open-pisciculture/open-source-fish-farming-prototypes/rfm95w-breakout/README.md

# RFM95W Breakout Board

This is a printed circuit board designed for easier breadboard prototyping with an RFM95W module. 
3D models, PCB documentation and manufacturing files are available. The PCB design Altium project is also included. 

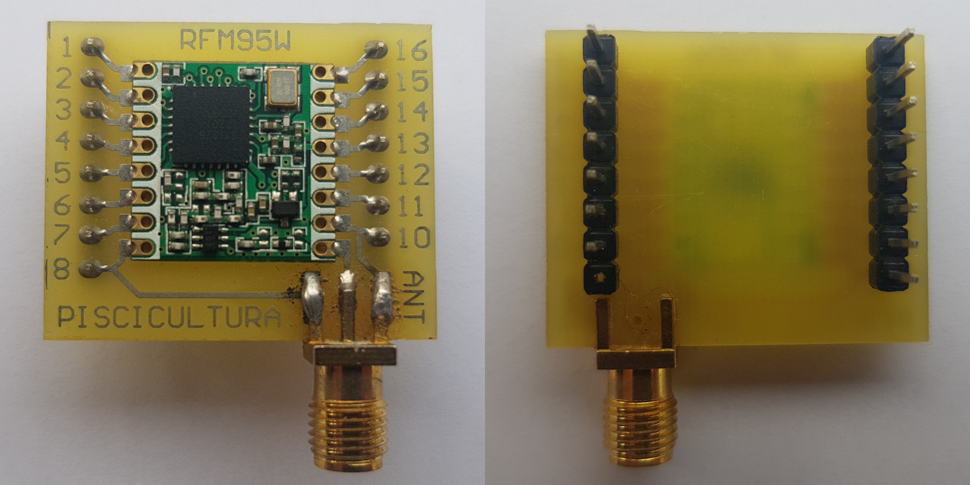
[picture p14: rfm95w-breakout/images/top_and_bottom.jpeg]
RFM95W breakout board front and back views
