open-pisciculture/open-source-fish-farming-prototypes/data-buoy-node/images/view.png

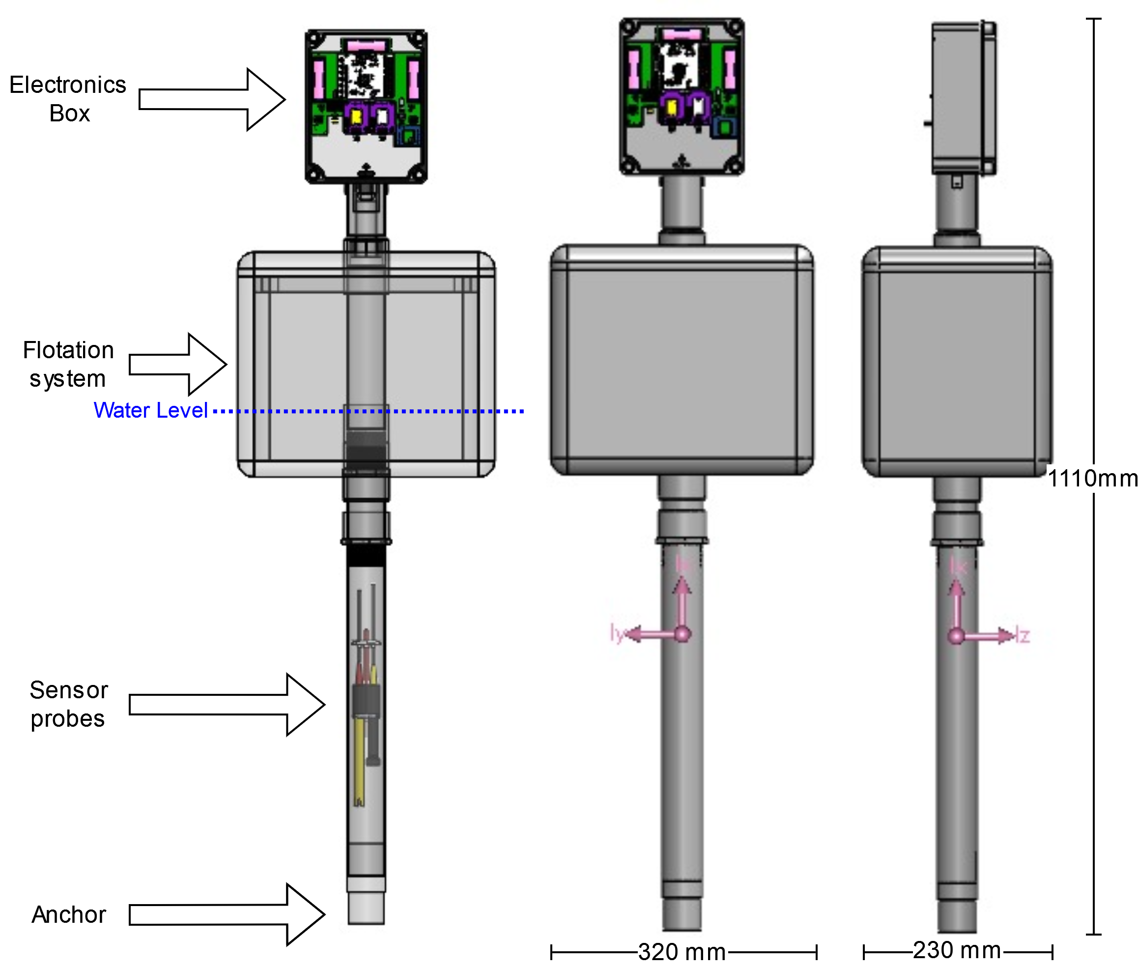
data-buoy-node/images/view.png
