open-pisciculture/open-source-fish-farming-prototypes/data-buoy-node/mechanical/documentation/BoxDimensions.jpeg

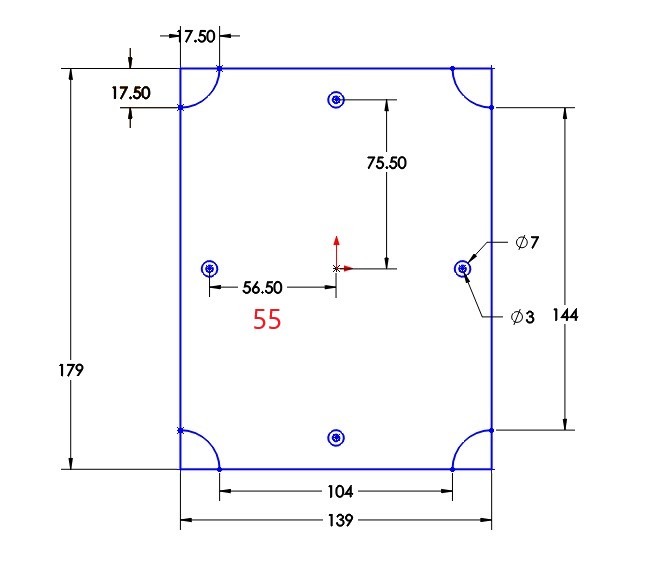
data-buoy-node/mechanical/documentation/BoxDimensions.jpeg
