open-pisciculture/open-source-fish-farming-prototypes/general/images/index.png

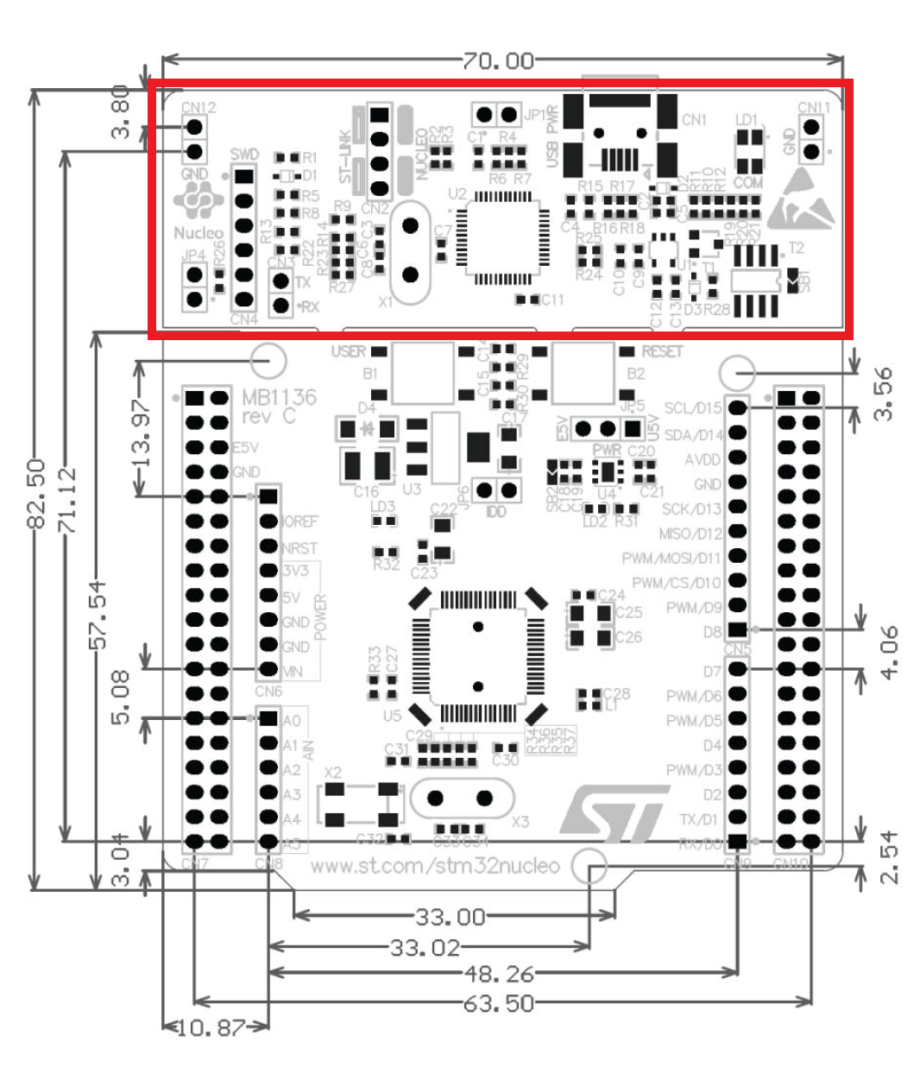
general/images/index.png
