open-pisciculture/open-source-fish-farming-prototypes/general/images/nucleo64_noprogrammer.jpeg

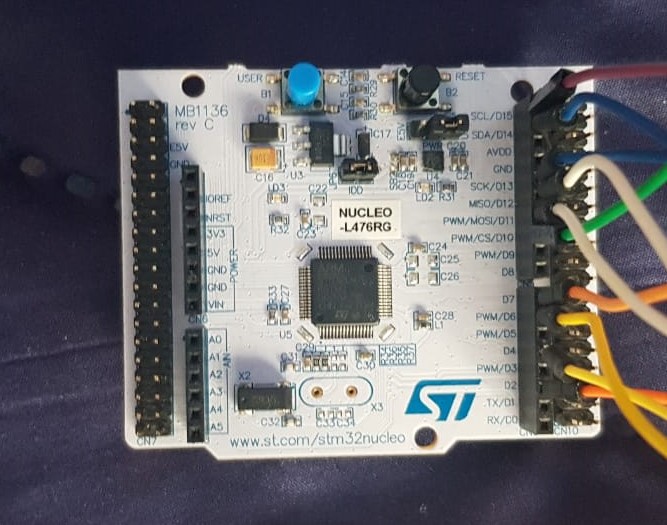
general/images/nucleo64_noprogrammer.jpeg
