open-pisciculture/open-source-fish-farming-prototypes/data-buoy-node/bill_of_materials_colombia.xlsx

Sección | Tipo | Producto | Cantidad | Precio por Unidad (COP) | Precio total (COP) | Precio por Unidad (USD) | Precio Total (USD) | Notas
Mecánica | Partes | Nevera 10 L de poliestireno expandido (https://www.homecenter.com.co/homecenter-co/product/377035/nevera-icopor-10-litros/377035/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) | 1 | $14500.00 | $14500.00
 |  | Caja de derivación 180mm x 140mm x 80mm (https://www.homecenter.com.co/homecenter-co/product/165838/caja-de-derivacion-dexson-gris-18148/165838/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) | 1 | $30900.00 | $30900.00
 |  | Tubo PVC 1 1/2" 1m (https://www.homecenter.com.co/homecenter-co/product/04593/tubo-11-2x1m-presion-21-200-psi/04593/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) | 1 | $11350.00 | $11350.00
 |  | Tubo PVC 3/4" 1m (https://www.homecenter.com.co/homecenter-co/product/04724/tubo-3-4x1m-presion-21-200-psi/04724/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) | 1 | $3450.00 | $3450.00
 |  | Unión PVC 1 1/2" (https://www.homecenter.com.co/homecenter-co/product/04604/union-1-1-2-presion/04604/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) | 1 | $2650.00 | $2650.00
 |  | Adaptador Macho 1 1/2" (https://www.homecenter.com.co/homecenter-co/product/04608/adaptador-macho-11-2-presion/04608/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) | 2 | $4100.00 | $8200.00
 |  | Adaptador Hembra 1 1/2" (https://www.homecenter.com.co/homecenter-co/product/37488/adaptador-hembra-11-2-presion/37488/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) | 2 | $4900.00 | $9800.00
 |  | Buje soldado 1 1/2" x 3/4" (https://www.homecenter.com.co/homecenter-co/product/04748/buje-soldado-11-2x3-4-presion/04748/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) | 1 | $3650.00 | $3650.00
 |  | Tapón soldado 1 1/2" (https://www.homecenter.com.co/homecenter-co/product/04619/tapon-soldado-11-2-presion/04619/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) | 1 | $3800.00 | $3800.00
 |  | Prensa estopa 1/2" 13.5mm (https://www.homecenter.com.co/homecenter-co/product/242697/prensa-estopa-1-2-pulgada-135mm/242697/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) | 1 | $2700.00 | $2700.00
 |  | Unión PVC 3/4 (https://www.homecenter.com.co/homecenter-co/product/04719/union-3-4-presion/04719/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) | 1 | $650.00 | $650.00
Electrónica | Componentes LoRaWAN | Módulo LoRa Transceptor RFM95W 915MHz (https://www.didacticaselectronicas.com/index.php/comunicaciones/lora/m%C3%B3dulo-rf-tranceptor-rfm95w-915mhz-tarjetas-modulos-tranceptores-lora-lo-ra-de-largo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) | 1 | $30464.00 | $30464.00
 |  | RFM95W tarjeta breakout | 1 | $7542.00 | $7542.00 | $2.00 | $2.00 | Costo calculado ordenando una cotización en la página jlcpcb.com y convirtiendo el valor a pesos colombianos
 |  | Cable RF SMA Macho a SMA Hembra 20cm (https://www.didacticaselectronicas.com/index.php/comunicaciones/conectores/extensi%C3%B3n-de-sma-macho-a-sma-hembra-de-20cm-cables-extensiones-extensores-para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) | 1 | $8211.00 | $8211.00
 |  | Terminal Tipo Anillo 6.2mm (https://www.didacticaselectronicas.com/index.php/suiches-y-conectores/conectores2016-02-07-20-36-39_/terminales/terminal-aislada-amarilla-tipo-fast-on-hembra-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) | 1 | $833.00 | $833.00
 |  | Antena 900 MHz 5dBi SMA Macho (https://www.didacticaselectronicas.com/index.php/comunicaciones/antenas/900mhz/antena-900mhz-5dbi-antenas-para-xbee-antenas-para-lora-lo-ra-antenas-omnidirecc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) | 1 | $8806.00 | $8806.00
 | Microcontrolador, Alimentación y demás | NUCLEO-L476RG (https://www.sigmaelectronica.net/producto/nucleo-l476rg/) | 1 | $140420.00 | $140420.00
 |  | Resistencia 5.1kOhms (https://www.sigmaelectronica.net/producto/rax1-4w-1k-ohm-5/) | 2 | $36.00 | $72.00 |  |  | Sigma Electrónica vende mínimo 10 unidades.
 |  | Resistencia 20kOhms (https://www.electronicaplugandplay.com/componentes-pasivos/resistencias/resistencias-de-carbon/product/101-resistencia-20k-1-4-watt) | 1 | $70.00 | $70.00 |  |  | Electrónica Plug and Play vende mínimo 10 unidades.
 |  | MOSFET IRLZ44N (https://www.sigmaelectronica.net/producto/irlz44n/) | 1 | $5950.00 | $5950.00
 |  | Regleta Header Macho 1x40 Pines 2.54mm (https://www.didacticaselectronicas.com/index.php/suiches-y-conectores/headers/header-macho-1x40p-2-54mm-header-macho1x40-regletas-conectores-header-machos-de-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) | 1 | $404.60 | $404.60 |  |  | Separar en las siguientes porciones: 1x2 pines, 2x5 pines, 1x7 pines y 1x8 pines.
 |  | Regleta Header Hembra 2x40 Pines 2.54mm (https://www.didacticaselectronicas.com/index.php/suiches-y-conectores/headers/header-hembra-2x40p-2-54mm-h-hembra-2x40-regletas-conectores-header-hembras-de-2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) | 2 | $1547.00 | $3094.00 |  |  | Quitar 2 pines de un borde de cada regleta para que quede de 2x39 pines.
 |  | Regleta Header Hembra 1x40 Pines 2.54mm (https://www.didacticaselectronicas.com/index.php/suiches-y-conectores/headers/header-hembra-1x40p-2-54mm-con-087-header-hembra-1x40-regletas-conectores-header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) | 1 | $952.00 | $952.00 |  |  | Separar en las siguientes porciones: 2x3 pines, 2x5 pines, 1x7 pines y 1x8 pines.
 |  | Jumper de conexión 2.54mm (https://www.didacticaselectronicas.com/index.php/prototipado/accesorios-1/jumper-de-conexi%C3%B3n-2-54mm-negro-conectores-jumper-jumpers-de-conexion-detail) | 1 | $99.96 | $99.96
 |  | Regulador de voltaje MCP1700 3.3V 250mA (https://www.didacticaselectronicas.com/index.php/semiconductores/reguladores/reguladores-33v/regulador-de-voltaje-3-3v-250ma-mcp1700-3302e-to-reguladores-de-v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) | 1 | $1547.00 | $1547.00
 |  | Capacitor 1uF (https://www.didacticaselectronicas.com/index.php/componentes-pasivos/capacitores/de-tantalio/capacitor-de-tantalio-1uf-35v-condensadores-capacitores-condensad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) | 2 | $499.80 | $999.60
 |  | Switch mini deslizante 3 pines (https://www.didacticaselectronicas.com/index.php/suiches-y-conectores/suiches/deslizante/suiche-mini-deslizante-3-pines-2-posiciones-suiches-switch-interrupto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) | 1 | $345.10 | $345.10
 |  | Bornera 2 Pines (https://www.didacticaselectronicas.com/index.php/suiches-y-conectores/borneras/bornera-2p-azul-kf301-5mm-kf301-2p-tb2pos5b-borneras-terminales-con-borneras-sc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) | 2 | $476.00 | $952.00
 |  | Porta pila AA x1 (https://www.didacticaselectronicas.com/index.php/baterias-cargadores/portabaterias/porta-pila-aa-x1-portapilas-portabaterias-holder-soportes-para-bater%C3%ADa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) | 3 | $714.00 | $2142.00
 |  | Pila AA 2 unidades (https://www.exito.com/pilas-duracell-aa-2pz-12itx4ip-193555/p) | 2 | $9000.00 | $18000.00 |  |  | Se vende por 2 unidades. Solo se requieren 3 en el prototipo. Se puede cambiar por otra pila AA que también tenga tensión nominal de 1.5V.
 |  | Tornillo M3 x 6mm (https://www.didacticaselectronicas.com/index.php/robotica/tornillos-y-separadores/tornillos/tornillo-plastico-6mm-unidad-tornillos-metalicos-m3-6mm-detail) | 5 | $202.30 | $1011.50
 |  | Circuito Impreso Electrónica | 1 | $43743.60 | $43743.60 | $11.60 | $11.60 | Costo calculado ordenando una cotización en la página jlcpcb.com y convirtiendo el valor a pesos colombianos
Sensórica | Sondas, circuitos de lectura y conectores | Conector SMA Hembra (https://www.vistronica.com/conectores-cables-y-switches/conector-sma-ke-11mm-detail.html) | 1 | $1558.52 | $1558.52
 |  | Adaptador SMA Macho a BNC Hembra (https://www.amazon.com/-/es/Electronics-coaxial-adaptador-macho-hembra/dp/B00CVQLDX4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) | 1 | $18855.00 | $18855.00 | $5.00 | $5.00 | Se incluye link de Amazon como referencia, ya que no se encontraron distribuidores nacionales que vendan este producto por página web.
 |  | PT-1000 Temperature Kit (https://atlas-scientific.com/kits/pt-1000-temperature-kit/) | 1 | $279016.29 | $279016.29 | $73.99 | $73.99
 |  | pH Kit (https://atlas-scientific.com/kits/ph-kit/) | 1 | $644803.29 | $644803.29 | $170.99 | $170.99
 |  | Dissolved Oxygen Kit | 1 | $1172743.29 | $1172743.29 | $310.99 | $310.99
 |  | Sección | Precio Total (COP) | Porcentaje del Precio Total (%) |  | USD-COP | 3771
 |  | Mecánica | $91650.00 | 3.69%
 |  | Electrónica | $275659.36 | 11.10%
 |  | Sensórica | $2116976.39 | 85.21%
 |  | Prototipo Completo | $2484285.75 | 100.00%
 |  | Precio Total del Prototipo (USD) | $658.79
 |  | Section | Total Price (USD) | Percentage of Total Price (%)
 |  | Mechanical Structure | $24.30 | 3.69%
 |  | Electronics | $73.10 | 11.10%
 |  | Sensors | $561.38 | 85.21%
 |  | Complete Prototype | $658.79 | 100.00%
