open-pisciculture/open-source-fish-farming-prototypes/data-buoy-node/bill_of_materials.xlsx

BILL OF MATERIALS - DATA BUOY NODE
Description | Quantity needed
Circuit Components
HopeRF RFM95W module (https://www.hoperf.com/modules/lora/RFM95.html) | 1
RF cable SMA Male to SMA Female 15cm (https://www.amazon.com/-/es/TUOLNK-unidades-coaxial-adaptador-inal%C3%A1mbrica/dp/B091TH6CCJ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) | 1
NUCLEO-L476RG (https://www.st.com/en/evaluation-tools/nucleo-l476rg.html) | 1
5.1kOhms Resistor | 2
20KOhms Resistor | 1
IRLZ44N MOSFET (https://www.infineon.com/cms/en/product/power/mosfet/n-channel/irlz44n/) | 1
SMA Male to BNC Female Adapter | 1
PT-1000 Temperature Kit (https://atlas-scientific.com/kits/pt-1000-temperature-kit/) | 1
pH Kit (https://atlas-scientific.com/kits/ph-kit/) | 1
Dissolved Oxygen Kit (https://atlas-scientific.com/kits/dissolved-oxygen-kit/) | 1
Male Header Pin | 12
Female Header Pin | 92
Mini Slide Switch 3 Pin (https://www.pololu.com/product/1408) | 1
MCP1700 (https://www.microchip.com/en-us/product/MCP1700) | 1
1uF capacitor | 2
2 Pin Screw Terminal Block Connector | 2
AAx1 Battery Holder | 3
AA Battery | 3
Mechanical Parts
10L Polystyrene box | 1
PVC Pipe 1 1/2" | 1m
PVC Pipe 3/4" | 1m
PVC Coupling 1 1/2" | 1
PVC Male adapter 1 1/2" | 2
PVC Female adapter 1 1/2" | 2
PVC Reducer Bushing 1 1/2" x 3/4" | 1
PVC cap 1 1/2" | 1
Cable Gland PG13.5 | 1
PVC Coupling 3/4" | 1
