open-pisciculture/open-source-fish-farming-prototypes/gps-node/bill_of_materials.xlsx

BILL OF MATERIALS - GPS NODE
Description | Quantity needed
Circuit Components
GY-NEO6MV2 GPS Module | 1
HopeRF RFM95W module (https://www.hoperf.com/modules/lora/RFM95.html) | 1
NUCLEO-L476RG (https://www.st.com/en/evaluation-tools/nucleo-l476rg.html) | 1
Male Header Pin | 4
MCP1700 (https://www.microchip.com/en-us/product/MCP1700) | 1
2 Pin Screw Terminal Block Connector | 1
1uF capacitor | 2
AAx3 Battery Holder | 1
AA Battery | 3
Breadboard | 1
Cables and Jumpers | -
PLA filament | -
