open-pisciculture/open-source-fish-farming-prototypes/data-buoy-node/mechanical/3dmodels/step/DataBuoy.step

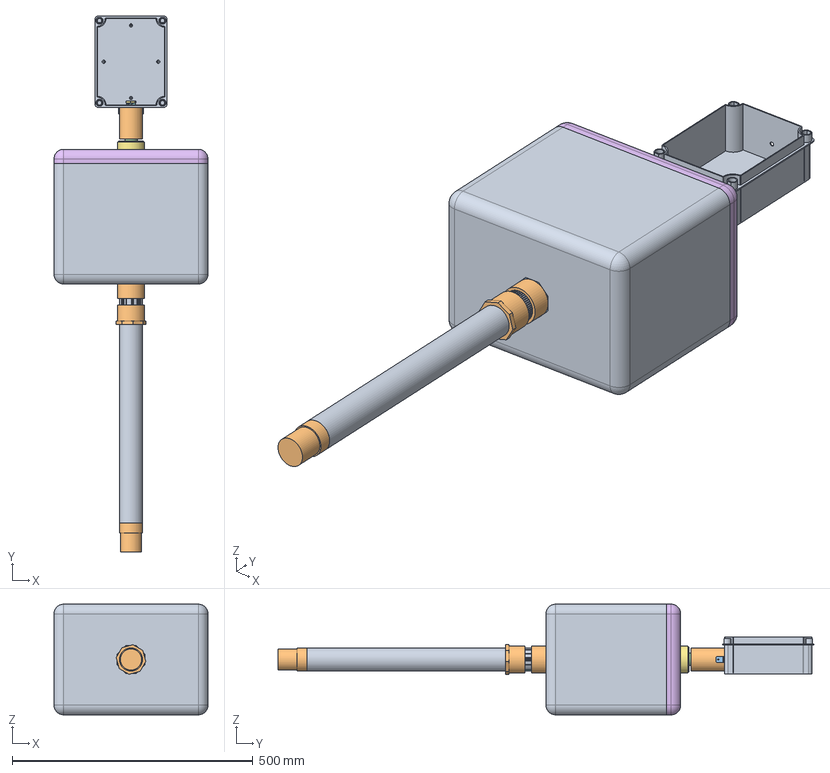
[picture p20: CAD file, 2022-04-05]
data-buoy-node/mechanical/3dmodels/step/DataBuoy.step
320.0 x 1114.0 x 230.0 mm
Nevera 10l
Macho 1_1_2 x 2
Sellador_elastico
Hembra 1-1-2 x 2
PVC 1-1-2-300mm
Tapa_nevera
Transicion_PVC_1_1_2
PVC 1-1-2-100mm
PVC 1-1-2-500mm
Tapon_peso
Buje_1_1_2_a_3_4
Prensa
estopa
Caja de paso Dexson
PVC 1-1-2-70mm
escuadra x 2
