open-pisciculture/open-source-fish-farming-prototypes/gps-node/mechanical/3dprinting/stl/gps-node-box.stl

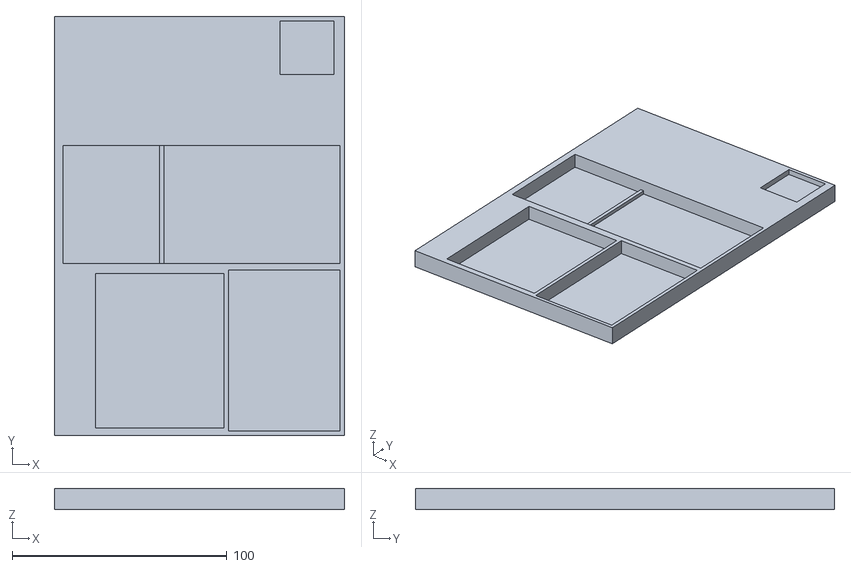
[picture p21: CAD file, 2022-03-02]
gps-node/mechanical/3dprinting/stl/gps-node-box.stl
135.0 x 195.0 x 10.0
