open-pisciculture/open-source-fish-farming-prototypes/rfm95w-breakout/3dmodels/RFM95W.step

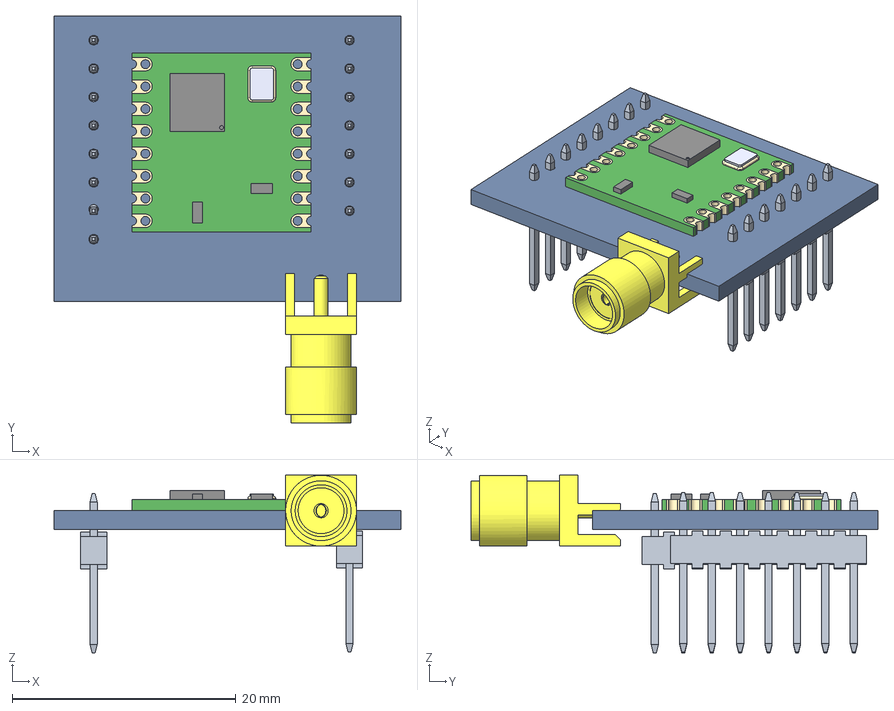
[picture p22: CAD file, 2022-03-01]
rfm95w-breakout/3dmodels/RFM95W.step
31.0 x 36.3 x 15.9 mm
SMA-J-P-H-ST-EM1
