open-pisciculture/open-source-fish-farming-prototypes/rfm95w-breakout/altium/3DModels/SMA-J-P-H-ST-EM1.stp

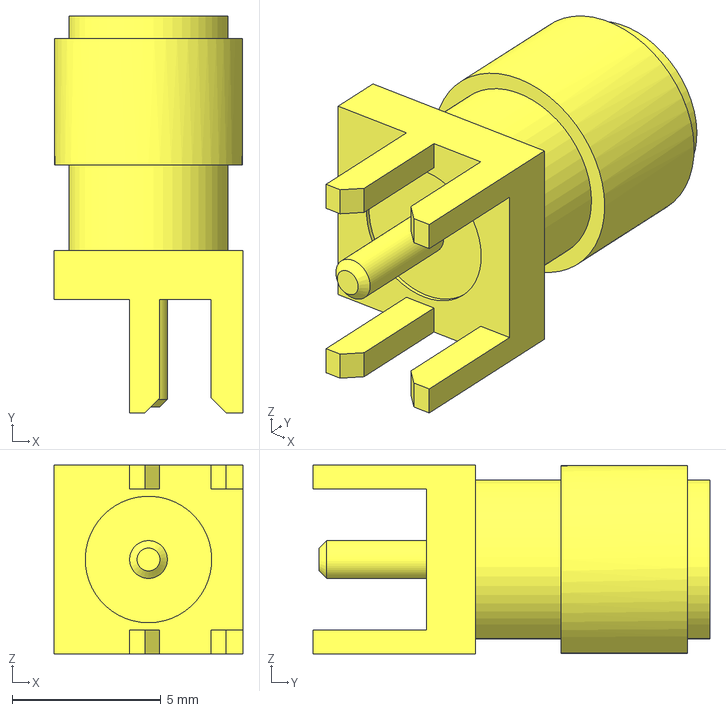
[picture p23: CAD file, 2022-03-01]
rfm95w-breakout/altium/3DModels/SMA-J-P-H-ST-EM1.stp
6.35 x 13.3 x 6.35 mm
