open-pisciculture/open-source-fish-farming-prototypes/rfm95w-breakout/altium/3DModels/022102071.stp

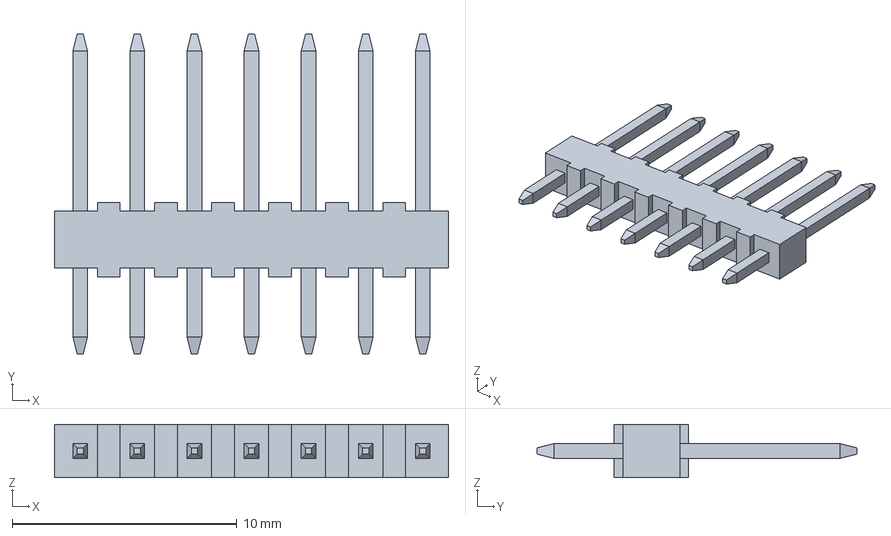
[picture p24: CAD file, 2022-03-01]
rfm95w-breakout/altium/3DModels/022102071.stp
17.5 x 14.2 x 2.36 mm
