open-pisciculture/open-source-fish-farming-prototypes/rfm95w-breakout/altium/3DModels/022102061.stp

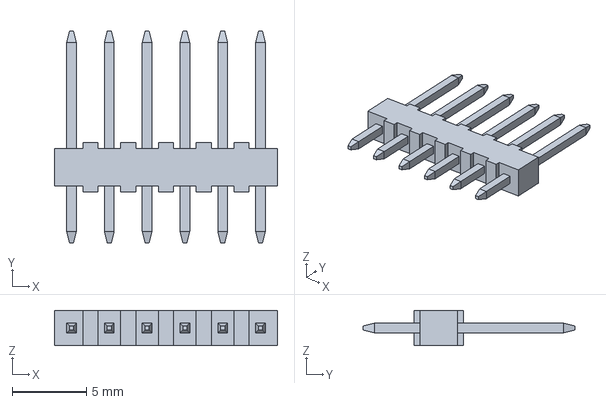
[picture p25: CAD file, 2022-03-01]
rfm95w-breakout/altium/3DModels/022102061.stp
15.0 x 14.2 x 2.36 mm
