open-pisciculture/open-source-fish-farming-prototypes/rfm95w-breakout/altium/3DModels/022102081.stp

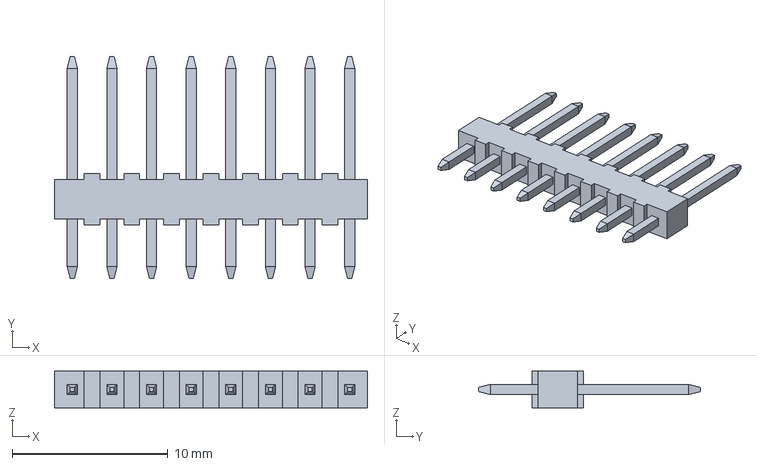
[picture p26: CAD file, 2022-03-01]
rfm95w-breakout/altium/3DModels/022102081.stp
20.1 x 14.2 x 2.36 mm
