open-pisciculture/open-source-fish-farming-prototypes/(list of files, cad)

Other CAD files:
gps-node/mechanical/3dprinting/step/gps_node_box_v1 v3.step
