open-pisciculture/open-source-fish-farming-prototypes/data-buoy-node/assembly_guide.docx

Assembly guide

1. Parts list
2. Subsection assembly
3. Final assembly
1. Parts list

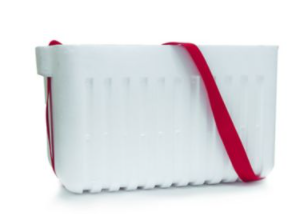
[picture p27: figure]

a) 10 L polystyrene box (x1)

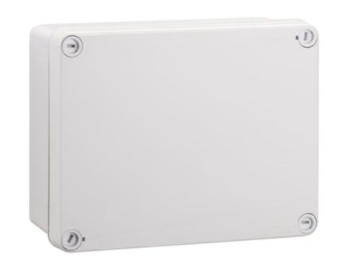
[picture p28: figure]

b) Electrical box 180mm x 140mm x 80mm (x1)

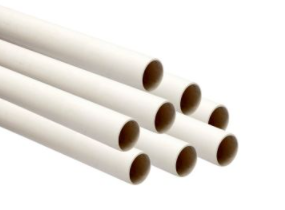
[picture p29: figure]

c) PVC Pipe 1 1/2" cut to 600mm length (x1) d) PVC Pipe 1 1/2" cut to 180mm length (x1)

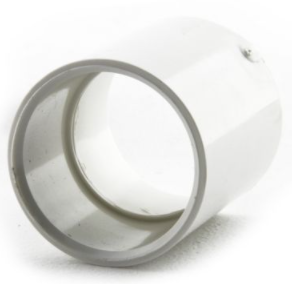
[picture p30: figure]
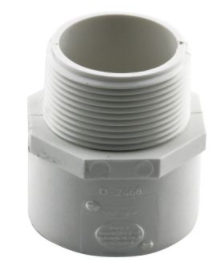
[picture p31: figure]
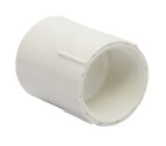
[picture p32: figure]

e) PVC Coupling 1 1/2" (x1) f) Male adapter 1 1/2" (x2) g) Female adapter 1 1/2" (x2)

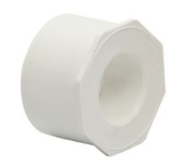
[picture p33: figure]
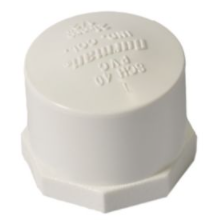
[picture p34: figure]

h) PVC reducer bushing 1 1/2" x 3/4" (x1) i) PVC cap 1 1/2" (x1)

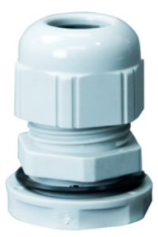
[picture p35: figure]
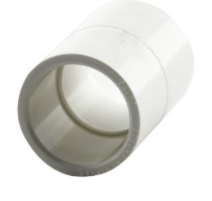
[picture p36: figure]

j) Cable Gland PG13.5 1/2" (x1) k) PVC Coupling 3/4" (x1)

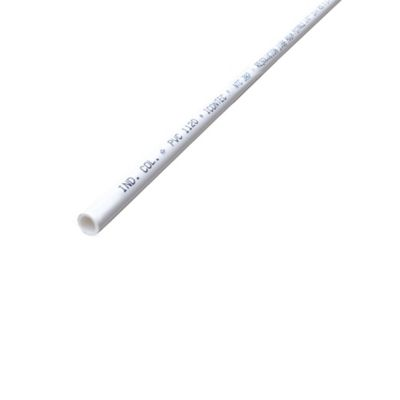
[picture p37: figure]
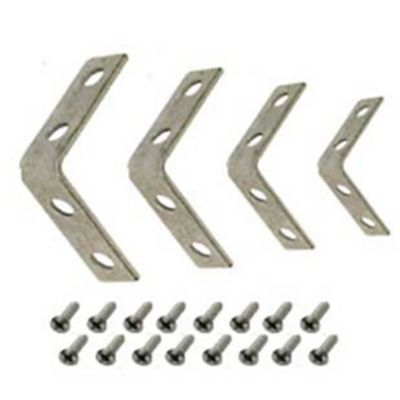
[picture p38: figure]

l) PVC Pipe 3 /4" cut to 50mm length (x1) m) PVC Pipe 3 /4" cut to 70mm length (x1) n) L shape clamp (x2) and screws o) Teflon

2. Subsection assembly

2.1 Buoy

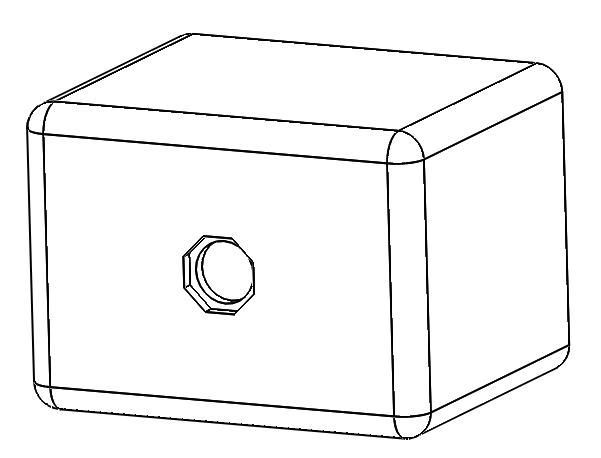
[picture p39: figure]
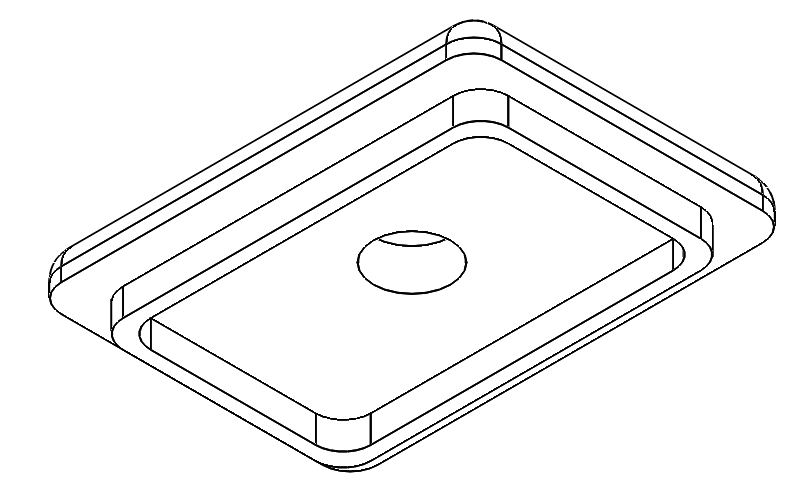
[picture p40: figure]

- Mark the center of the base and cap of the 10L box. - Drill a 47mm diameter hole for the box base. This corresponds to the diameter of accessory (f). - Drill a 56 mm diameter hole for the box cap. This corresponds to the diameter of accessory (e).

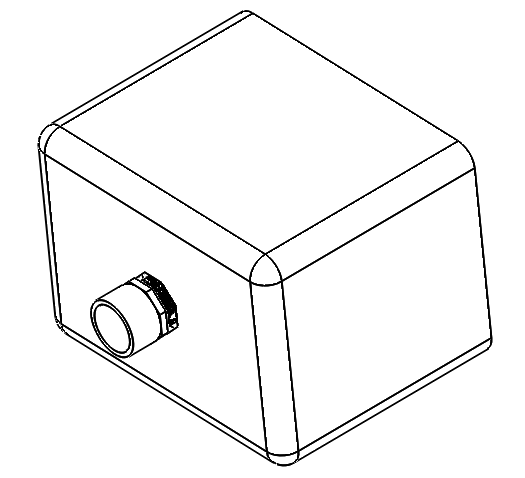
[picture p41: figure]
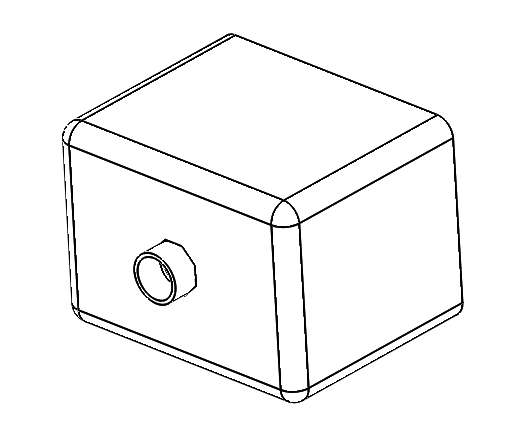
[picture p42: figure]
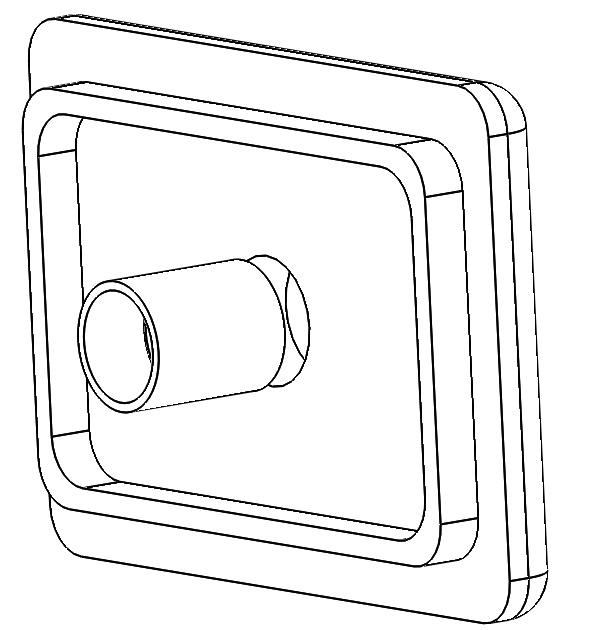
[picture p43: figure]
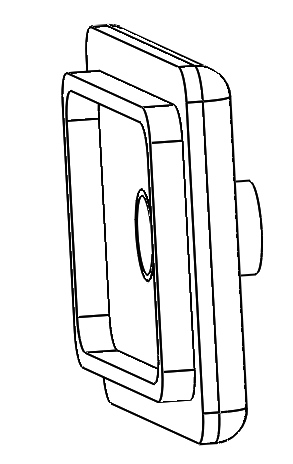
[picture p44: figure]

- Insert the male adapter (f) into the box base and join them with your preferred elastic sealant. - Insert the coupling (e) to the box cap and join them with your preferred elastic sealant.

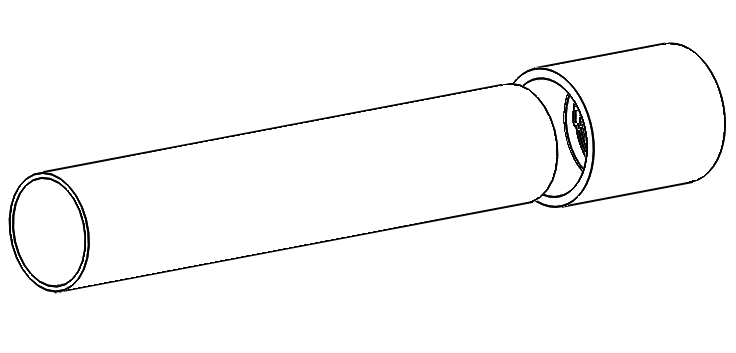
[picture p45: figure]
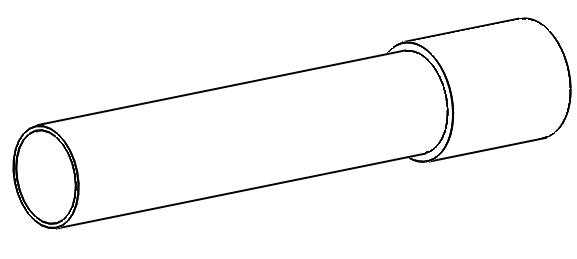
[picture p46: figure]

- Inside the box, weld the female adapter (g) with PVC pipe (d) to join the male adapter (f) and coupling (e).

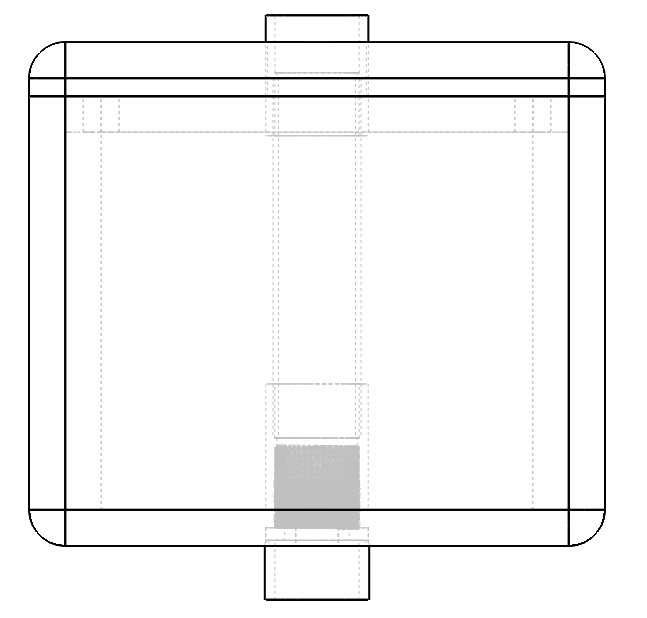
[picture p47: figure]
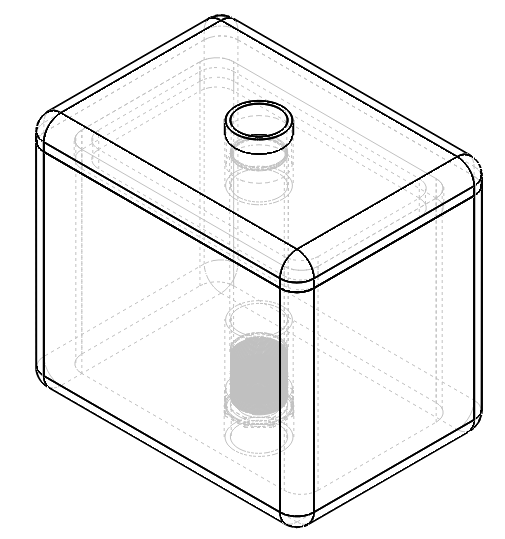
[picture p48: figure]

- Use Teflon on the male adapter (f) thread and adjust the female adapter (g).

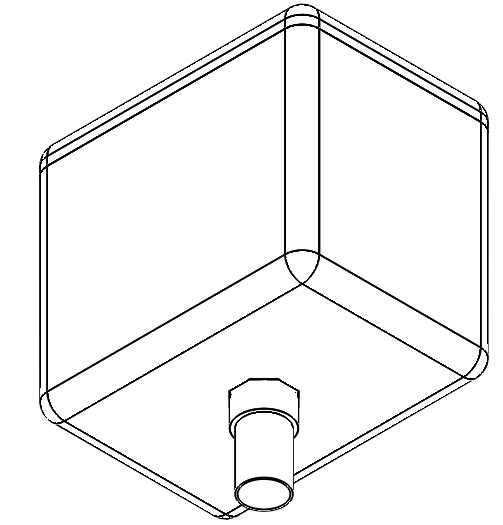
[picture p49: figure]
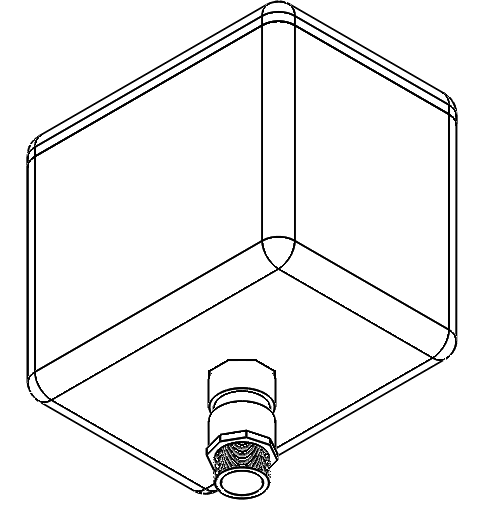
[picture p50: figure]

- Finally, weld the bottom section of the remaining male adapter (f) using a small piece of PVC pipe.

2.2 Electronic devices protection

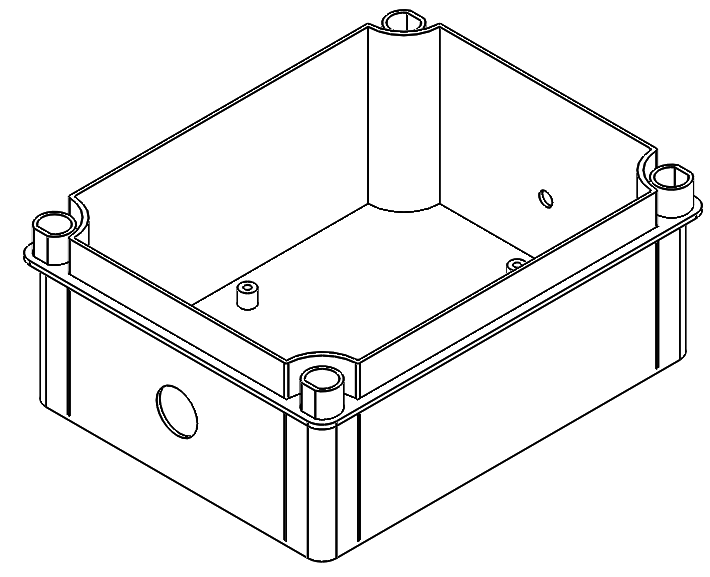
[picture p51: figure]

- Mark the center of the top and bottom sections of the box (b) (140 mm x 80mm side). - For the bottom section, drill a 1/2" diameter hole and clean the borders. The cable gland (j) will be placed here. - For the top section, drill a 1/4" diameter hole where the antenna will be located.

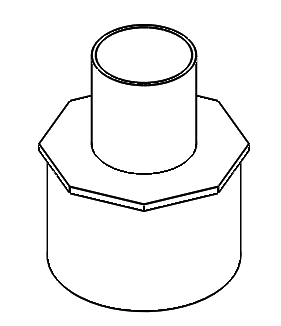
[picture p52: figure]

- Weld the reducer bushing (h) to the 50mm section of 3 /4" PVC pipe (I).

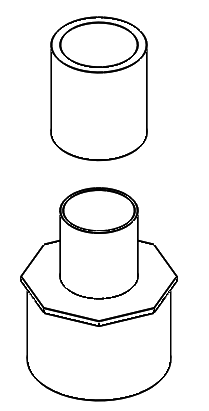
[picture p53: figure]
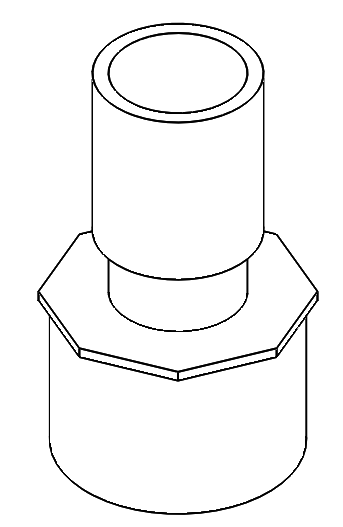
[picture p54: figure]

- Weld the top section of the 3 /4" PVC pipe to the coupling (k).

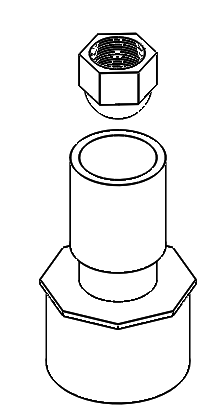
[picture p55: figure]
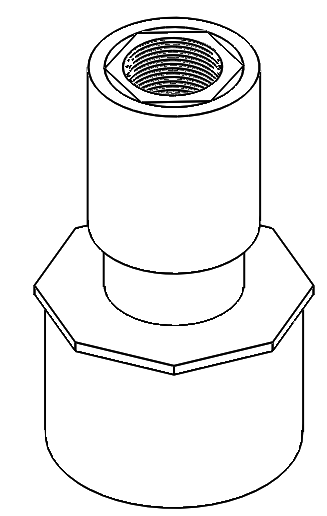
[picture p56: figure]

- Take the thread of element (j) and insert it into the top section of the coupling (k). Use your preferred sealant to join them.

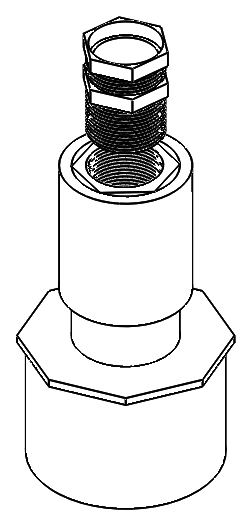
[picture p57: figure]
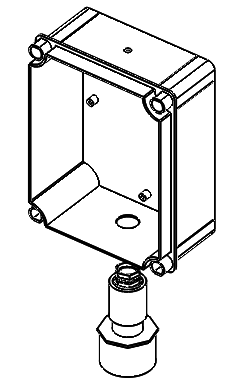
[picture p58: figure]
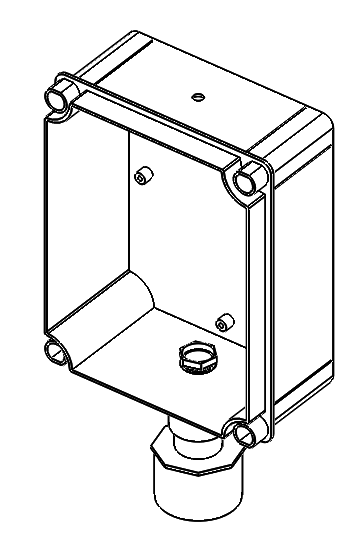
[picture p59: figure]

- Adjust accessory (j) to the box (b) and the thread from the earlier step.

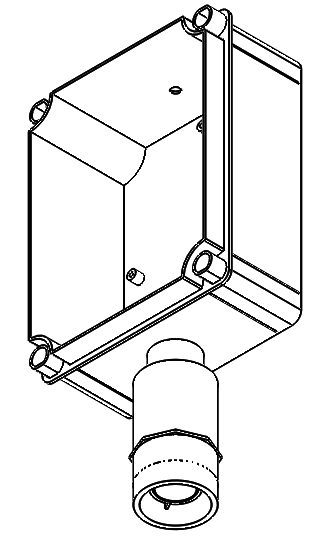
[picture p60: figure]
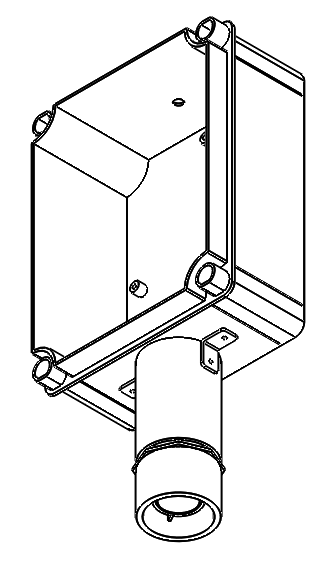
[picture p61: figure]

- Finally, to protect the accessory (j) and increase the box stability, a 70mm section of PVC pipe (m) is added and secured with an L shape clamp and screws (n).

2.3 Sensor probe protection

- Weld the cap (i) to one side of the PVC pipe (c).
- On the other side, place the female accessory (g).

3. Final assembly

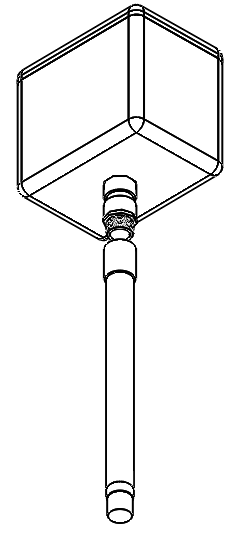
[picture p62: figure]

- Take the buoy and probe protection from sections 2.1 and 2.3 and assemble them by screwing the male and female accessories.

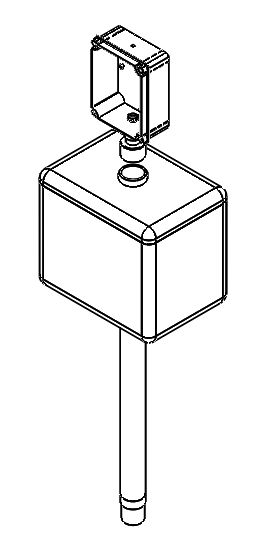
[picture p63: figure]

- Finally, grab the electronics protection from section 2.2 and adjust the accessory (e) to the accessory (h).
