open-pisciculture/open-source-fish-farming-prototypes/data-buoy-node/images/operating.jpeg

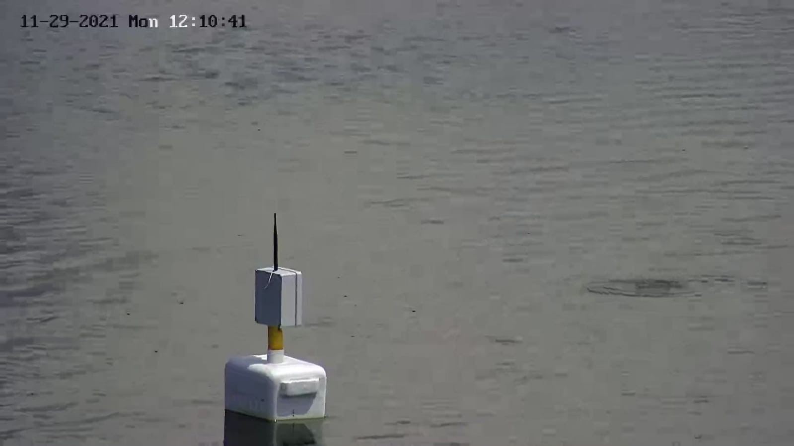
data-buoy-node/images/operating.jpeg
