open-pisciculture/open-source-fish-farming-prototypes/CHANGES.TXT.txt

## CHANGES LOG FILE ##
# INFORMATION CAN ONLY BE ADDED AND NOT REMOVED FROM THIS FILE
# PLEASE NOTE WHEN THE DESIGN HAS CHANGED, INCLUDING DATE AND INFORMATION ABOUT THE CHANGES
# CONSULT THE CERN-OHL-P HOW TO GUIDE FOR DETAILS

# 14/3/2022 # 
ORIGINAL DESIGN UPLOAD
