open-pisciculture/open-source-fish-farming-prototypes/rfm95w-breakout/documentation/RFM95W_Breakout_Schematics.pdf

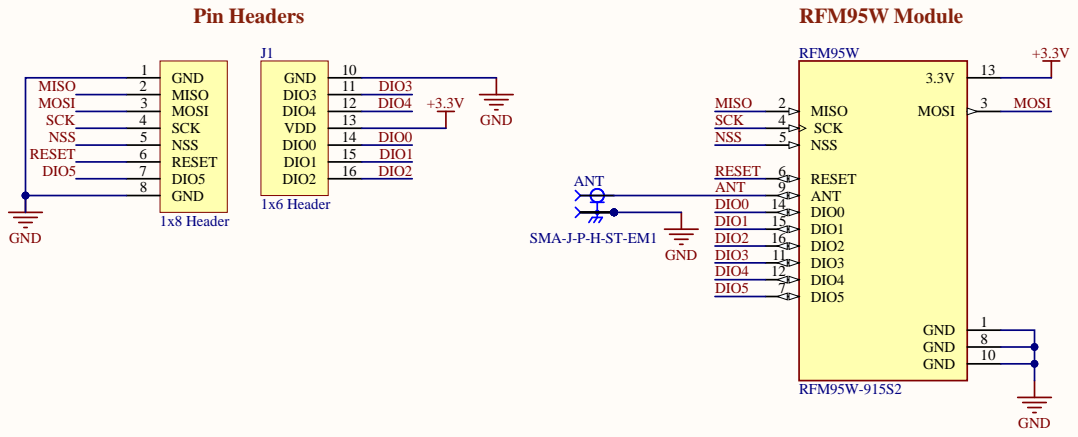
[picture p65: page 1]

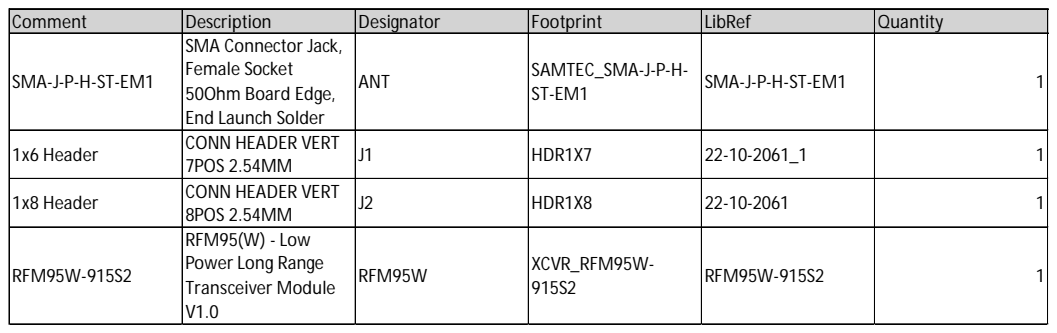
[picture p66: page 2]

Comment | Description | Designator | Footprint | LibRef | Quantity
SMA-J-P-H-ST-EM1 | SMA Connector Jack, Female Socket 50Ohm Board Edge, End Launch Solder | ANT | SAMTEC_SMA-J-P-H-ST-EM1 | SMA-J-P-H-ST-EM1 | 1

1x6 Header | CONN HEADER VERT 7POS 2.54MM | J1 | HDR1X7 | 22-10-2061_1 | 1

1x8 Header | CONN HEADER VERT 8POS 2.54MM | J2 | HDR1X8 | 22-10-2061 | 1

RFM95W-915S2 | RFM95(W) - Low Power Long Range Transceiver Module V1.0 | RFM95W | XCVR_RFM95W-915S2 | RFM95W-915S2 | 1
