open-pisciculture/open-source-fish-farming-prototypes/data-buoy-node/hardware/documentation/BuoyLoRaNode_PCB_Layout.pdf

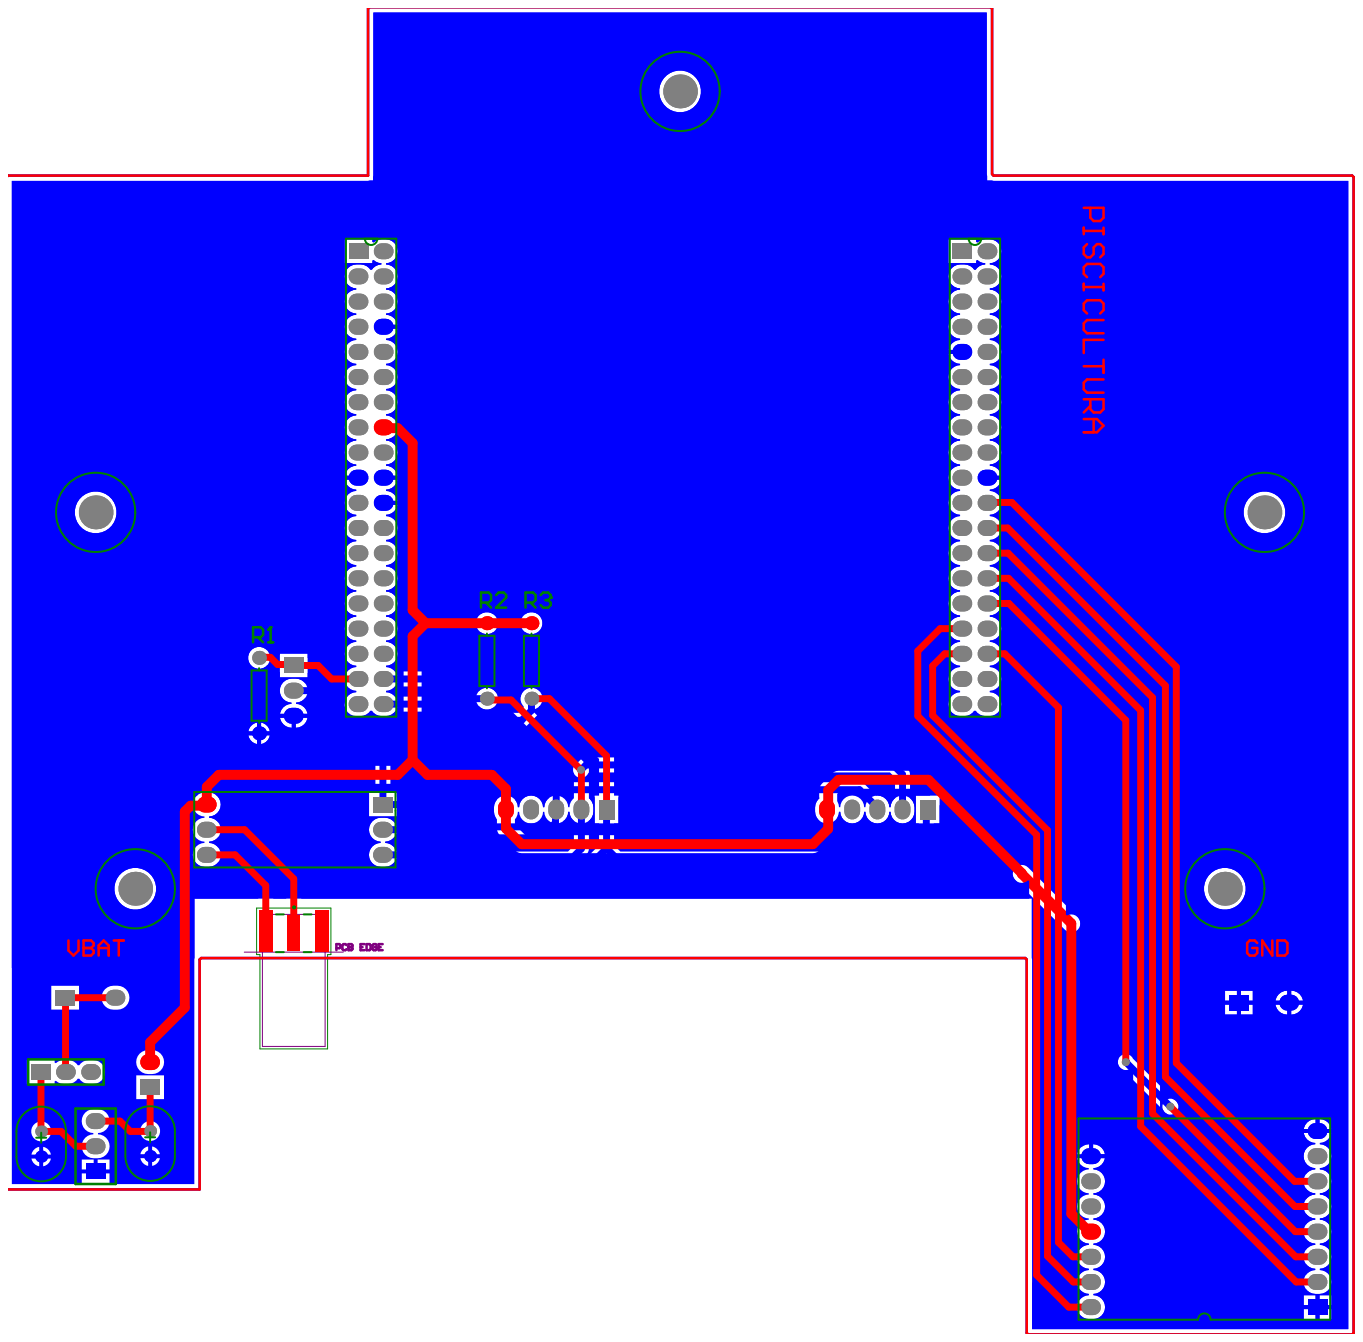
[picture p67: page 1]
