open-pisciculture/open-source-fish-farming-prototypes/data-buoy-node/hardware/altium/BuoyLoRaNode.pdf

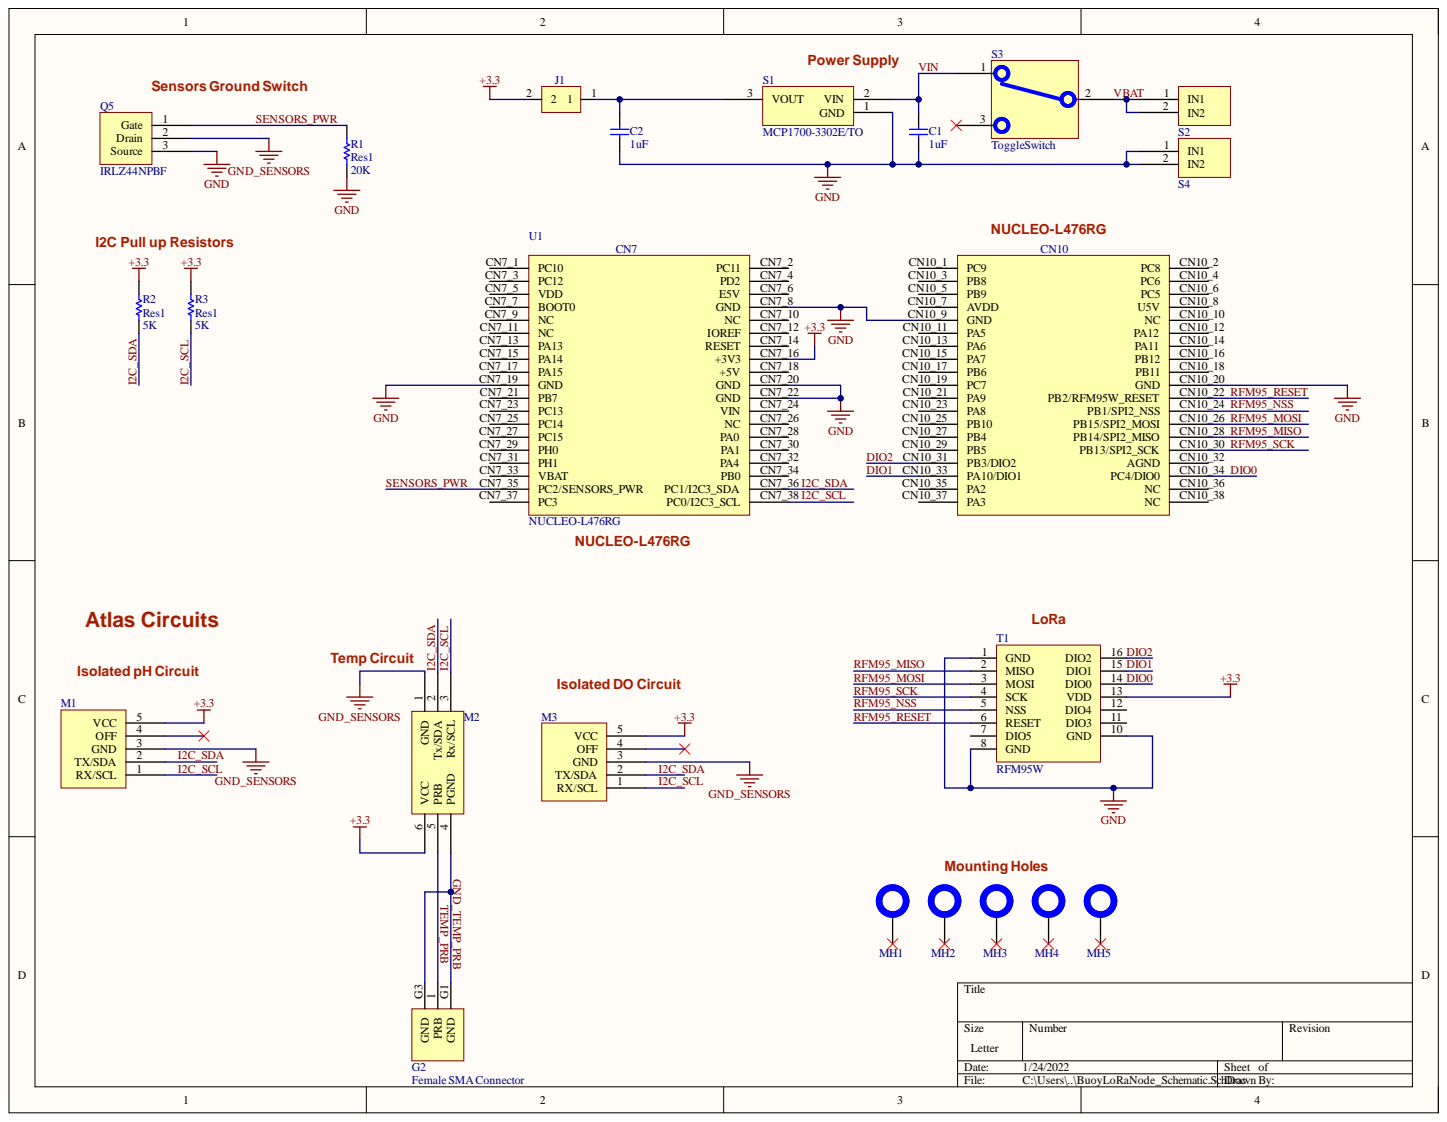
[picture p68: page 1]

Rx/SCL 3 PGND 4 PRB 5 VCC 6

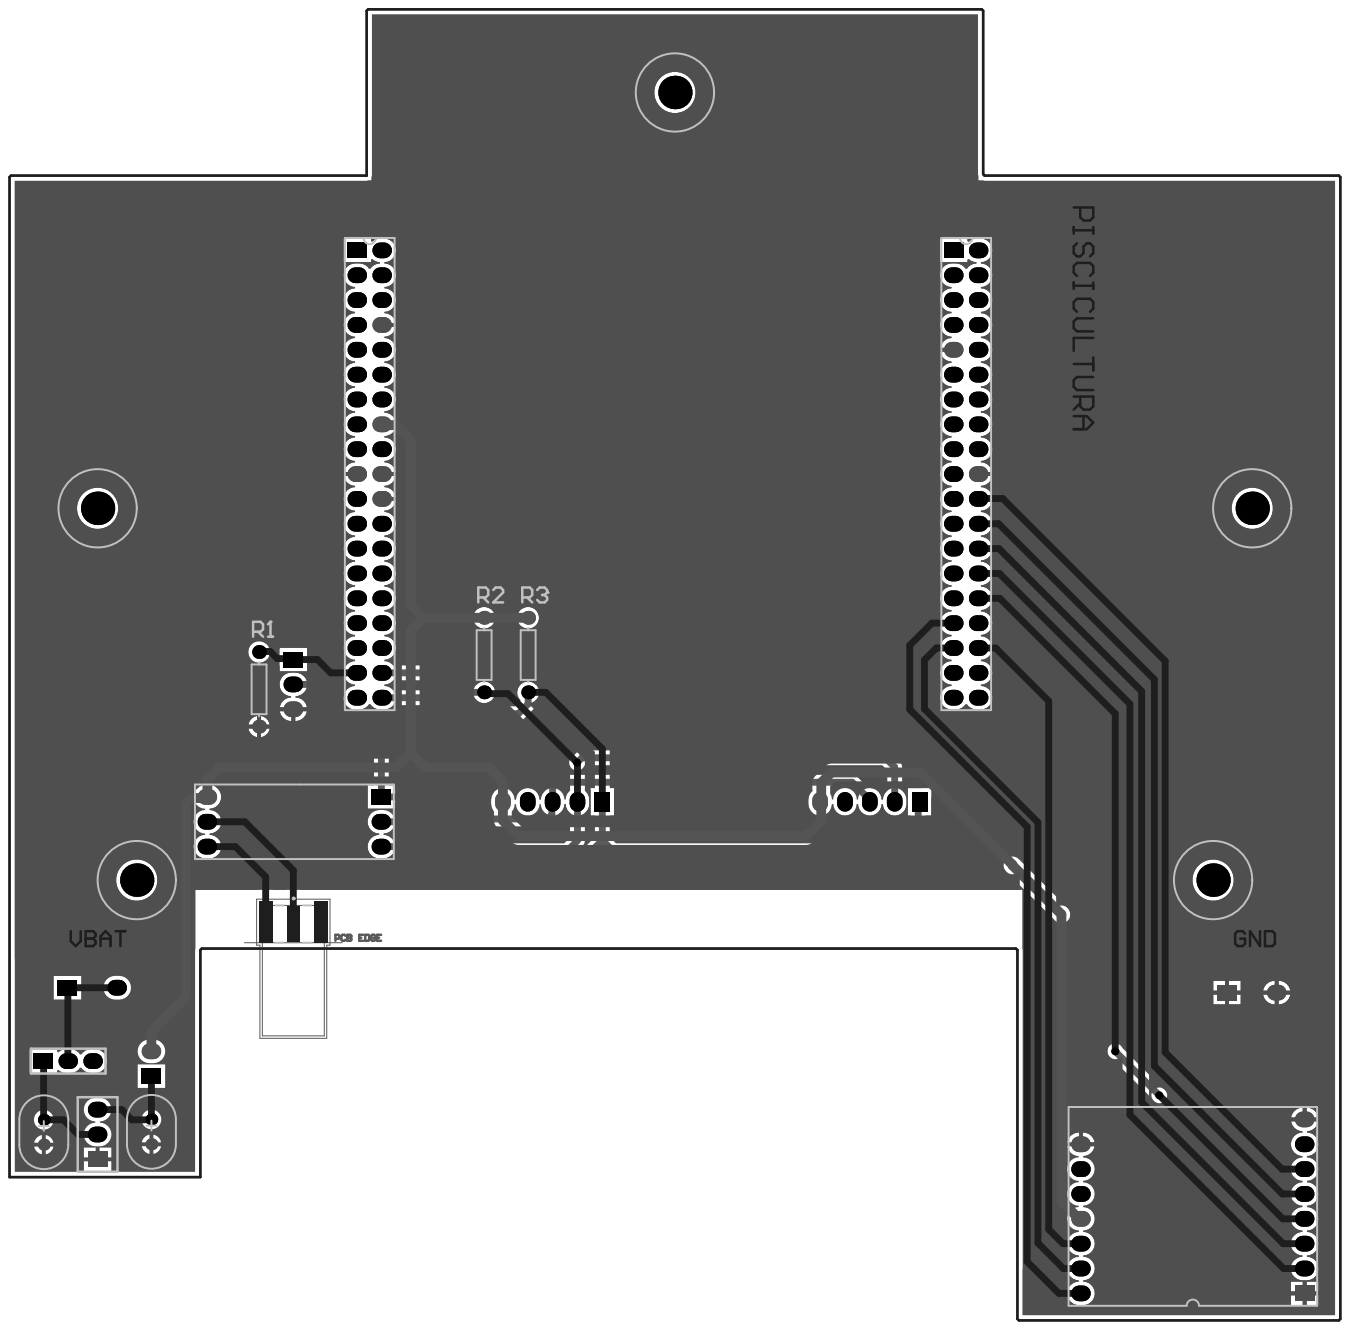
[picture p69: page 2]
