open-pisciculture/open-source-fish-farming-prototypes/gps-node/hardware/altium/GPSLoRaNode_Schematic.pdf

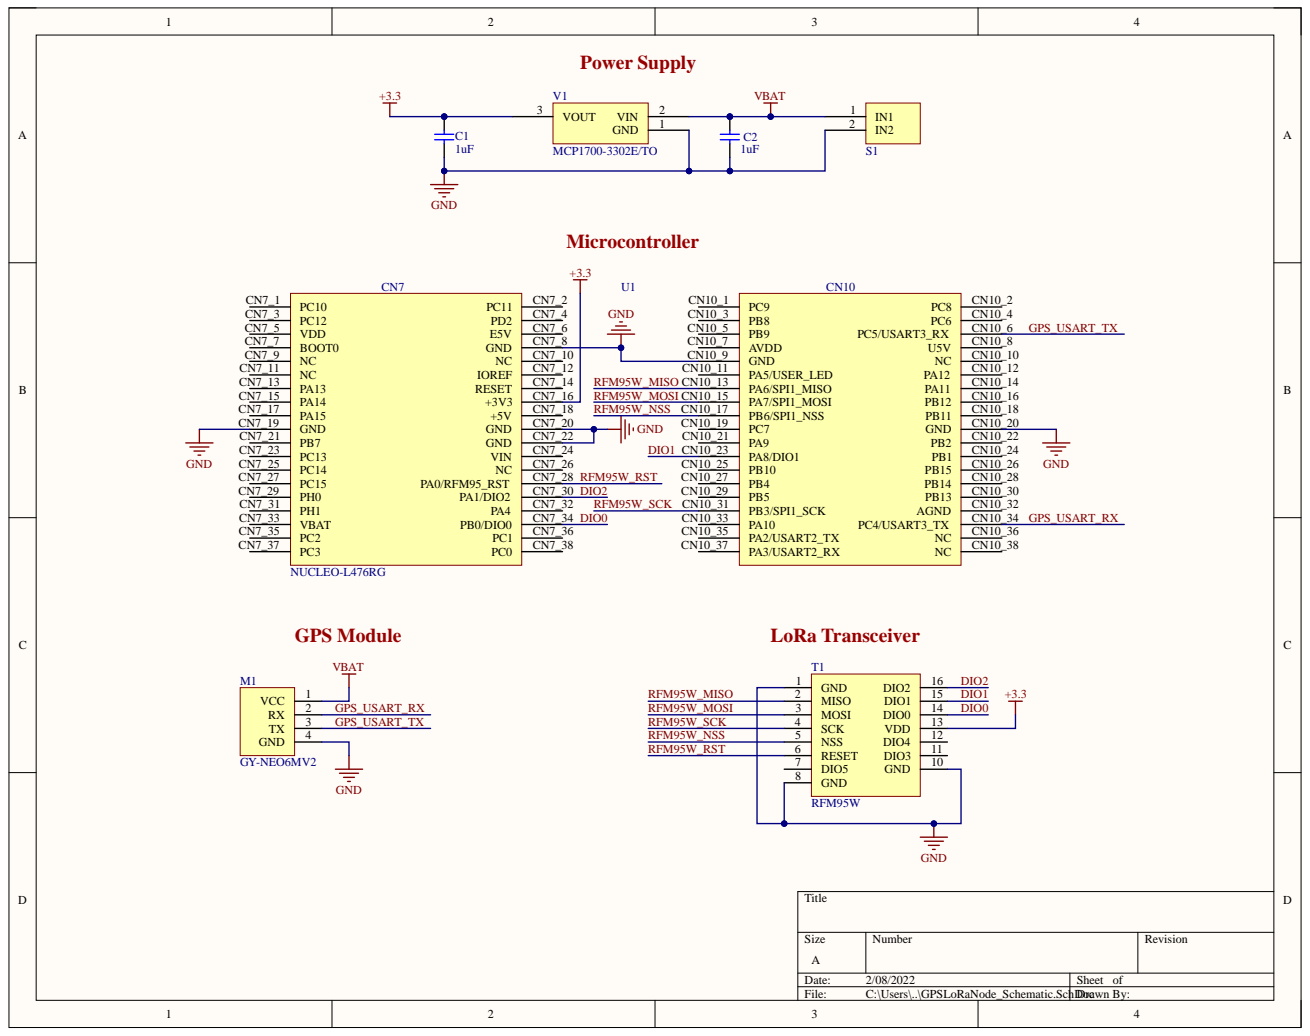
[picture p70: page 1]
