open-pisciculture/open-source-fish-farming-prototypes/gps-node/hardware/documentation/GPSLoRaNode_Schematics.pdf

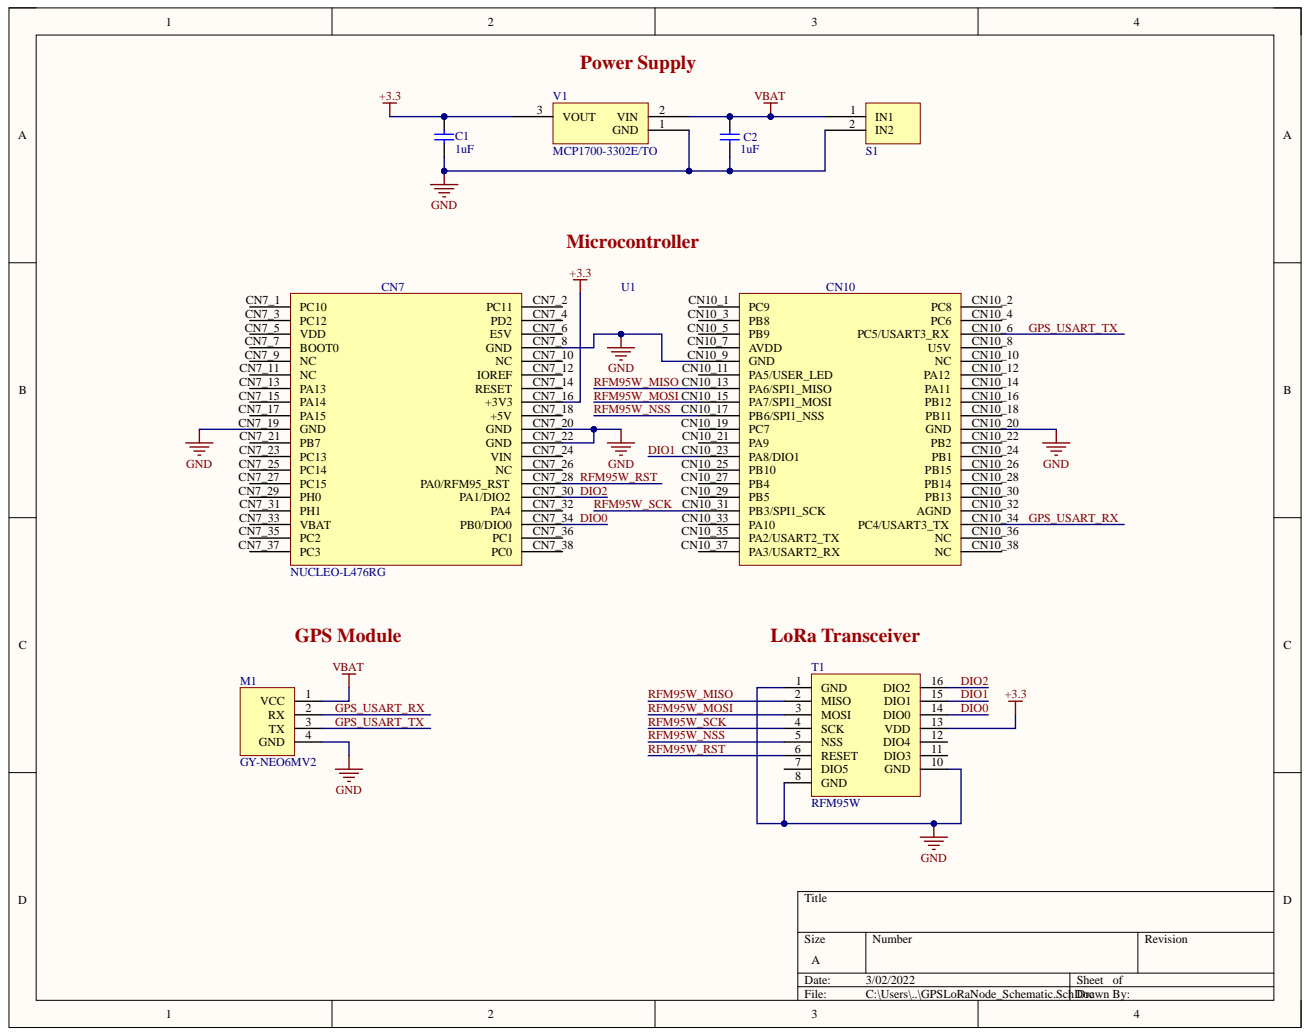
[picture p71: page 1]
