open-pisciculture/open-source-fish-farming-prototypes/data-buoy-node/hardware/documentation/BuoyLoRaNode_Schematic.pdf

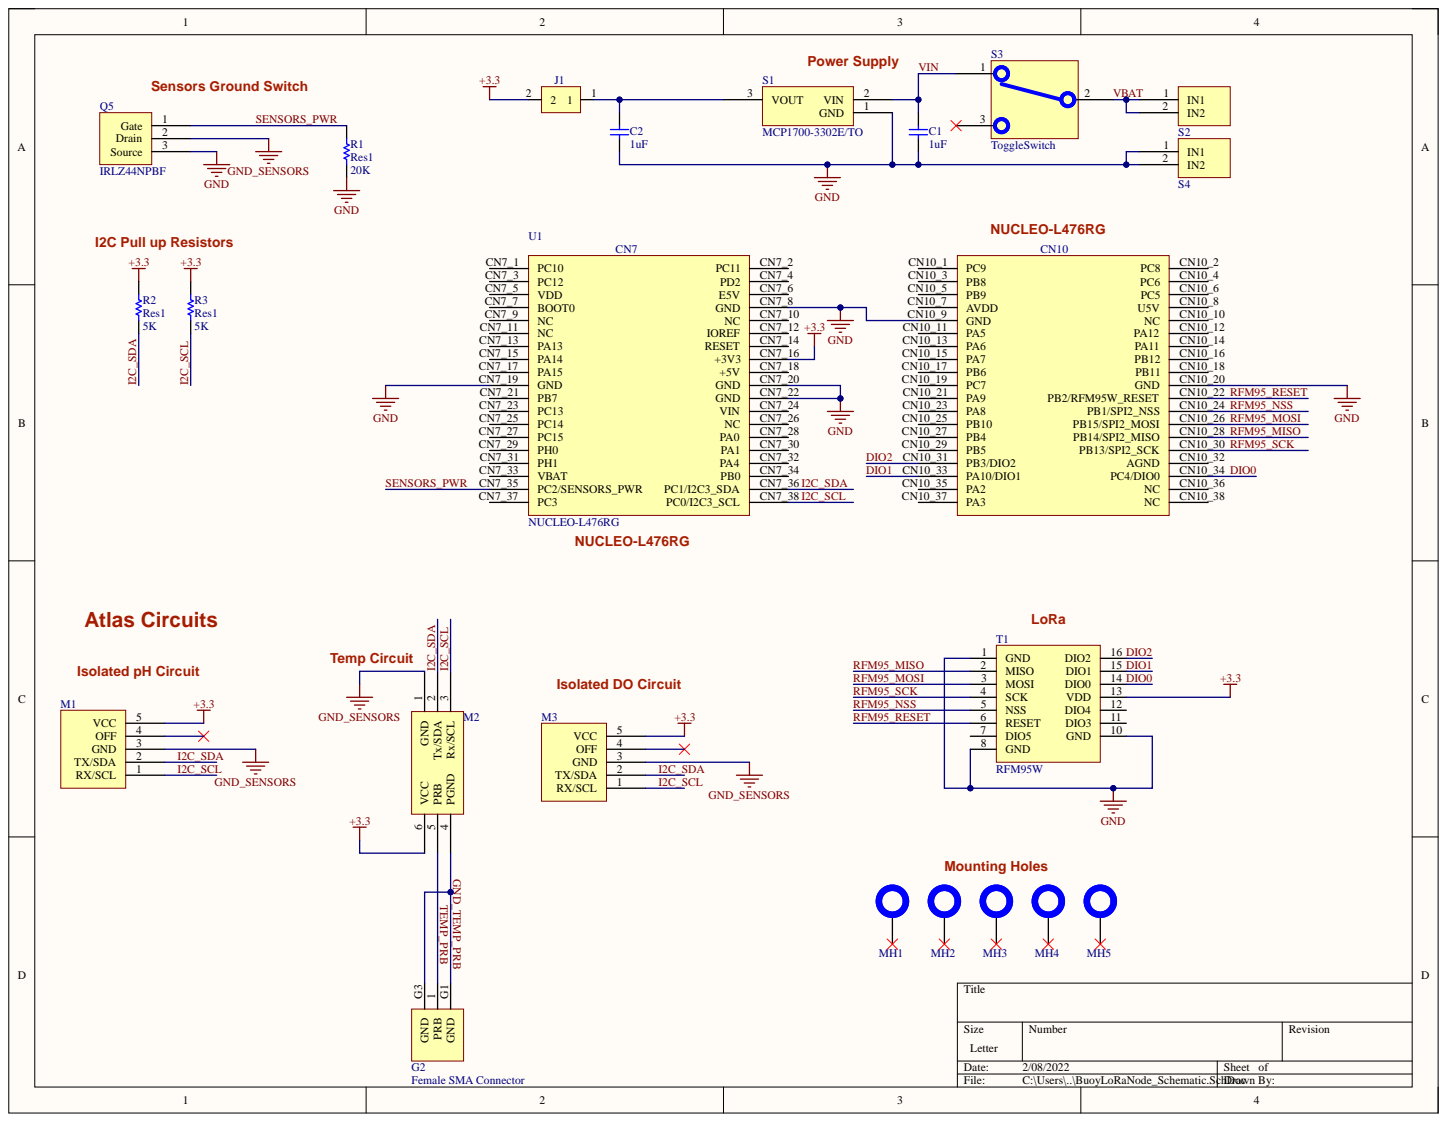
[picture p72: page 1]

Rx/SCL 3 PGND 4 PRB 5 VCC 6
