open-pisciculture/open-source-fish-farming-prototypes/rfm95w-breakout/documentation/RFM95W_PCB_Layout.pdf

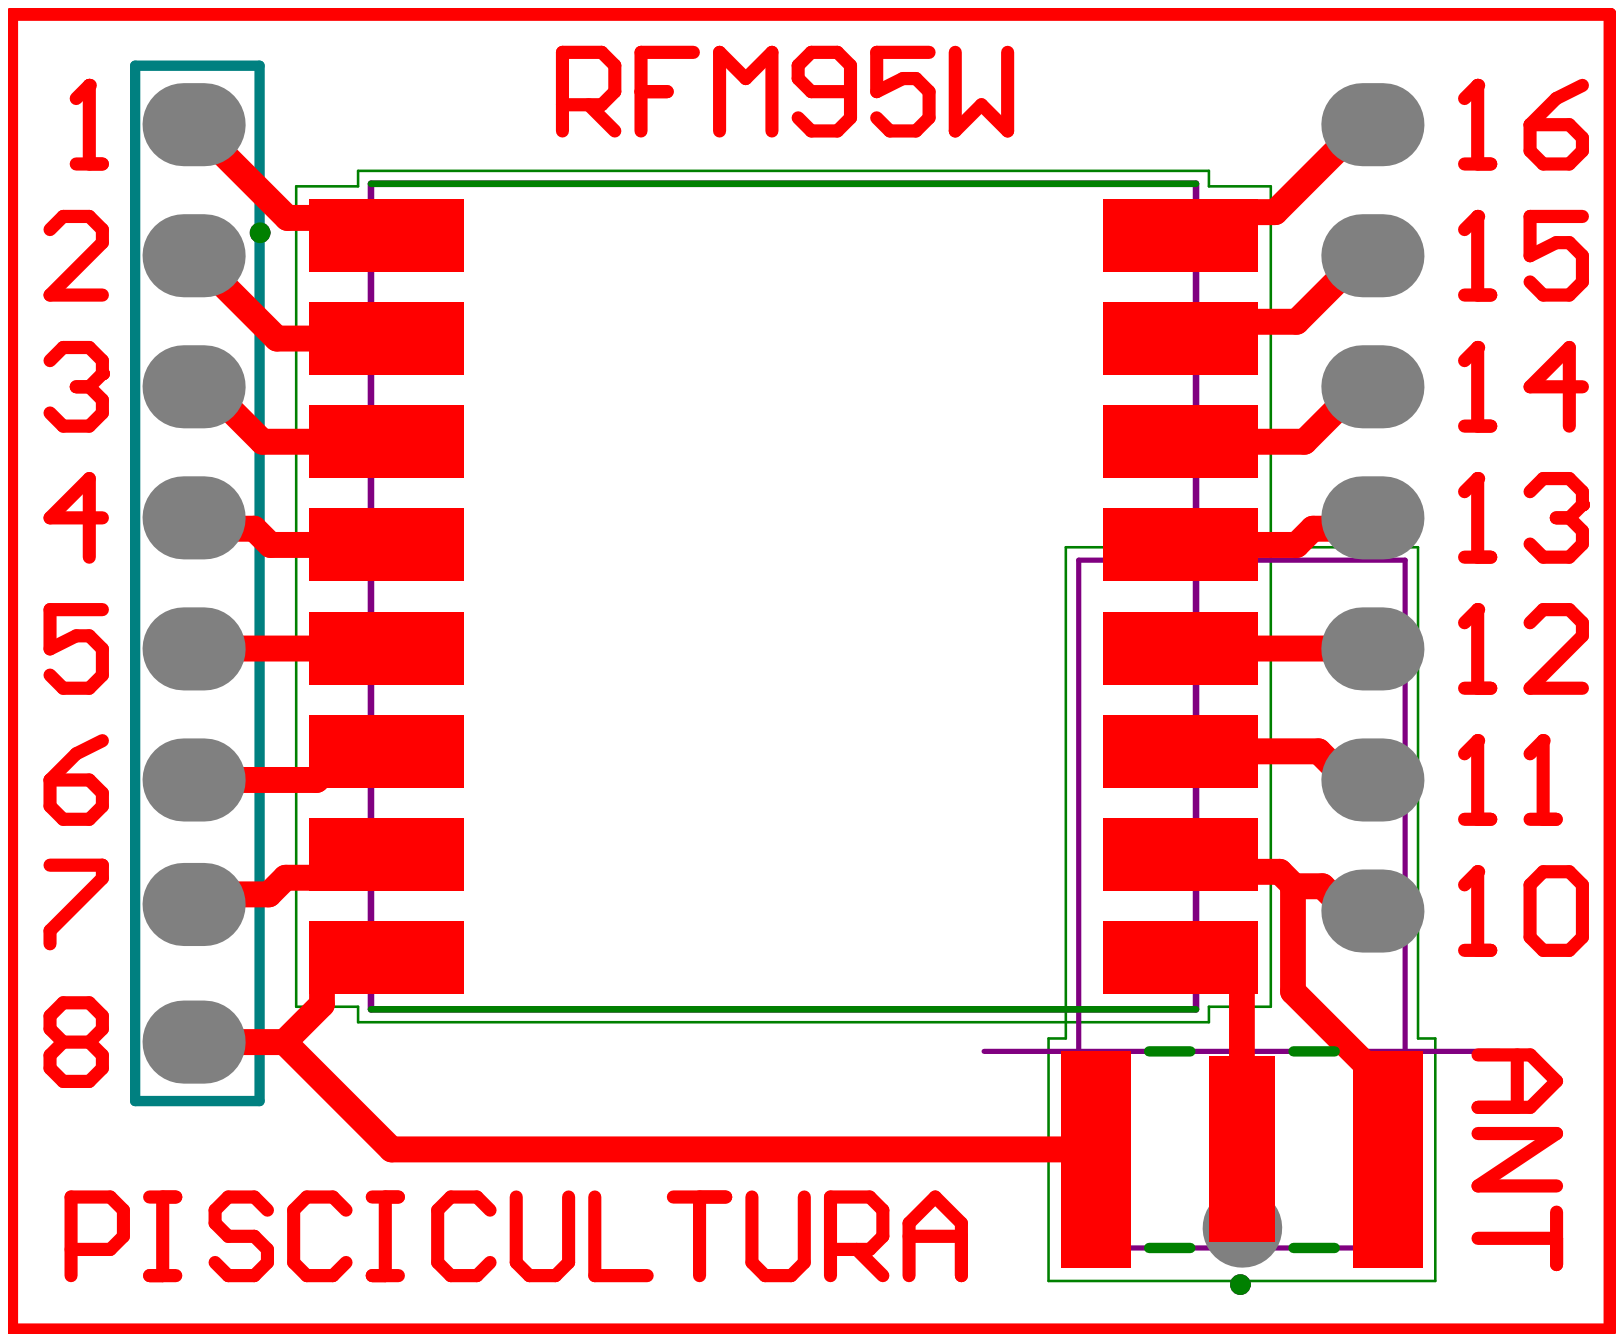
[picture p73: page 1]
