open-pisciculture/open-source-fish-farming-prototypes/(list of files, drawings)

Other design files:
data-buoy-node/hardware/altium/142-0701-841/142-0701-841.SchLib
data-buoy-node/hardware/altium/142-0701-841/JOHNSON_142-0701-841.PcbLib
data-buoy-node/hardware/altium/227161-1/SnapEDApcb.PcbLib
data-buoy-node/hardware/altium/227161-1/SnapEDAsch.SchLib
data-buoy-node/hardware/altium/BuoyLoRaNode.PrjPcb
data-buoy-node/hardware/altium/BuoyLoRaNode.SchLib
data-buoy-node/hardware/altium/BuoyLoRaNode_Schematic.SchDoc
data-buoy-node/hardware/altium/SMA-J-P-H-ST-EM1/SnapEDApcb.PcbLib
data-buoy-node/hardware/altium/SMA-J-P-H-ST-EM1/SnapEDAsch.SchLib
gps-node/hardware/altium/GPSLoRaNode.PrjPcb
gps-node/hardware/altium/GPSLoRaNode.SchLib
gps-node/hardware/altium/GPSLoRaNode_Schematic.SchDoc
rfm95w-breakout/altium/RFM95W915MHz.PrjPcb
rfm95w-breakout/altium/RFM95W.PcbDoc
rfm95w-breakout/altium/RFM95W.SchDoc
rfm95w-breakout/altium/RFM95W_PcbLib.PcbLib
rfm95w-breakout/altium/RFM95W_Schlib.SchLib
rfm95w-breakout/altium/SnapEDApcb.PcbLib
rfm95w-breakout/altium/SnapEDAsch.SchLib
rfm95w-breakout/altium/Temp/SMA-J-P-H-ST-EM1/SnapEDApcb.PcbLib
rfm95w-breakout/altium/Temp/SMA-J-P-H-ST-EM1/SnapEDAsch.SchLib
