open-pisciculture/open-source-fish-farming-prototypes/data-buoy-node/software/prototype-data-buoy/prototype-data-buoy.ioc

Mcu.UserName=STM32L476RGTx
PA10.GPIO_Label=DIO1
PA10.Signal=GPXTI10
PA5.GPIO_Label=USER_LED
PA5.Signal=GPIO_Output
PB1.GPIO_Label=SPI2_NSS
PB1.Signal=GPIO_Output
PB13.Signal=SPI2_SCK
PB14.Signal=SPI2_MISO
PB15.Signal=SPI2_MOSI
PB2.GPIO_Label=RFM95_RST
PB2.Signal=GPIO_Output
PC0.Signal=I2C3_SCL
PC1.Signal=I2C3_SDA
PC2.GPIO_Label=SENSORS_PWR
PC2.Signal=GPIO_Output
PC4.GPIO_Label=DIO0
PC4.Signal=GPXTI4
