open-pisciculture/open-source-fish-farming-prototypes/data-buoy-node/software/switch-atlas-i2c/Core/Src/main.c

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
/* Includes ------------------------------------------------------------------*/
#include "main.h"

UART_HandleTypeDef huart2;
UART_HandleTypeDef huart3;

void SystemClock_Config(void);
static void MX_GPIO_Init(void);
static void MX_USART2_UART_Init(void);
static void MX_USART3_UART_Init(void);
/**
  * @brief  The application entry point.
  * @retval int
  */
int main(void)
{
  /* MCU Configuration--------------------------------------------------------*/

  /* Reset of all peripherals, Initializes the Flash interface and the Systick. */
  HAL_Init();

  /* Configure the system clock */
  SystemClock_Config();

  /* Initialize all configured peripherals */
  MX_GPIO_Init();
  MX_USART2_UART_Init();
  MX_USART3_UART_Init();
  /* USER CODE BEGIN 2 */

  /*
   * Used to finish the command.
   */
  char cmd0[] = "\r";

  /*
   * Change the number in the cmd array to the desired I2C address for the sensor.
   * For example, I2C,104\r assigns the I2C address 104.
   *
   * The project uses:
   *
   * TEMPERATURE SENSOR I2C ADDRESS = 102;
   * pH SENSOR I2C ADDRESS = 103;
   * DISSOLVED OXYGEN SENSOR I2C ADDRESS = 104;
   *
   * Feel free to change the I2C address, if you prefer.
   * Keep in mind that only values between 1 and 127 are accepted.
   * Remember to change the I2C_ADDRESS macros in the main.c file for the data-buoy-node, if you change the I2C addresses.
   */
  char cmd[] = "I2C,104\r";

  /*
   * Buffers for data reception from sensors.
   */
  uint8_t rxbuffer0[10] = {0};
  uint8_t rxbuffer[9] = {0};

  /*
   * I'm not sure what happens during the first transmission in UART mode.
   * I think the circuit believes some character were sent to it during initialization.
   * Perhaps the pin used as Tx is set to some alternate function when reset?
   * Thus, any command sent will return an error. I solved this by sending the "\r" character,
   * which terminates the command, and reading the "*ER\r" received by the sensor.
   * After that, the sensor can be sent any command without any errors. At this point,
   * the command "I2C,n\r" is transmitted to change the sensor to I2C mode and assign the
   * I2C address n.
   */
  __HAL_UART_CLEAR_OREFLAG(&huart3);
  HAL_UART_Transmit(&huart3, (uint8_t *) cmd0, 1, 100);
  HAL_UART_Receive(&huart3, rxbuffer0, sizeof(rxbuffer0), 100);

  /*
   * Short delay between transmission.
   * Not necessary. However, the circuit LED briefly blinks red when an error occurs.
   * This delay enables the user to see the LED blink before the next transmission begins.
   */
  HAL_Delay(1000);

  /*
   * Transmit the command that changes the mode to I2C with the indicated I2C address.
   */
  HAL_UART_Transmit(&huart3, (uint8_t *) cmd, sizeof(cmd) - 1, 100);
  HAL_UART_Receive(&huart3, rxbuffer, sizeof(rxbuffer), 1000);
  /* USER CODE END 2 */

  /* Infinite loop */
  /* USER CODE BEGIN WHILE */
  while (1)
  {
    /* USER CODE END WHILE */
    /* USER CODE BEGIN 3 */
  }
  /* USER CODE END 3 */
}

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
