open-pisciculture/open-source-fish-farming-prototypes/gps-node/software/prototype-gps-node/Core/Inc/main.h

#define USER_BTN_Pin GPIO_PIN_13
#define USER_BTN_GPIO_Port GPIOC
#define USER_BTN_EXTI_IRQn EXTI15_10_IRQn
#define RFM95_RST_Pin GPIO_PIN_0
#define RFM95_RST_GPIO_Port GPIOA
#define DIO2_Pin GPIO_PIN_1
#define DIO2_GPIO_Port GPIOA
#define DIO2_EXTI_IRQn EXTI1_IRQn
#define USART_TX_Pin GPIO_PIN_2
#define USART_TX_GPIO_Port GPIOA
#define USART_RX_Pin GPIO_PIN_3
#define USART_RX_GPIO_Port GPIOA
#define USER_LED_Pin GPIO_PIN_5
#define USER_LED_GPIO_Port GPIOA
#define DIO0_Pin GPIO_PIN_0
#define DIO0_GPIO_Port GPIOB
#define DIO0_EXTI_IRQn EXTI0_IRQn
#define DIO1_Pin GPIO_PIN_8
#define DIO1_GPIO_Port GPIOA
#define DIO1_EXTI_IRQn EXTI9_5_IRQn
#define TMS_Pin GPIO_PIN_13
#define TMS_GPIO_Port GPIOA
#define TCK_Pin GPIO_PIN_14
#define TCK_GPIO_Port GPIOA
#define SPI1_NSS_Pin GPIO_PIN_6
#define SPI1_NSS_GPIO_Port GPIOB
