open-pisciculture/open-source-fish-farming-prototypes/(commit log)

2022-03-01 Adding section folders and STM32CubeIDE project
2022-03-01 Changing STM32CubeIDE project name
2022-03-01 Reorganizing folder hierarchy. Adding Altium projects and 3dmodels
    [022102061.stp, 022102071.stp, 022102081.stp, RFM95W.PcbDoc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]
2022-03-01 Fixing error
    [RFM95W.GBL, RFM95W.GBS, RFM95W.GTL, RFM95W.GTS]
2022-03-01 Editing readme to show the breakout board
2022-03-02 Adding schematic files and Altium project
    [RFM95W.PcbDoc, RFM95W.SchDoc, RFM95W915MHz.PrjPcb, RFM95W_Schlib.SchLib, SnapEDApcb.PcbLib]
2022-03-02 Adding gps node altium project and schematics
    [GPSLoRaNode.PrjPcb, GPSLoRaNode.SchLib, GPSLoRaNode_Schematic.SchDoc]
2022-03-02 Adding gps node box for 3d printing
    [gps-node-box.stl]
2022-03-02 Adding STM32CubeIDE project
2022-03-02 Adding gps software flowchart
2022-03-02 Adding PCB layout pdf
    [RFM95W.PcbDoc, RFM95W915MHz.PrjPcb]
2022-03-02 Adding gps breadboard circuit setup
2022-03-02 Adding gps node schematics
2022-03-02 Flipping breadboard circuit image
2022-03-02 Adding data buoy pcb altium project
    [142-0701-841.SchLib, BuoyLoRaNode.PrjPcb, BuoyLoRaNode.SchLib, BuoyLoRaNode_Schematic.SchDoc, JOHNSON_142-0701-841.PcbLib, SnapEDApcb.PcbLib, SnapEDAsch.SchLib]
2022-03-02 Adding software flowchart and organizing some folders
2022-03-02 renaming gps-node schematics folder to documentation
2022-03-07 Adding a section that briefly describes each prototype
2022-03-07 Adding prototype images
2022-03-07 Adding assembled buoy image to README
2022-03-08 Documenting prototype-data-buoy main.c
2022-03-08 Documenting gps-node main.c and fixing some typos
    [main.c]
2022-03-08 Adding components to rfm952-breakout altium project schematic and pc libraries
    [BuoyLoRaNode.PrjPcb, RFM95W915MHz.PrjPcb, RFM95W_PcbLib.PcbLib, RFM95W_Schlib.SchLib]
2022-03-14 Adding cern-ohl-p how to guide
    [BuoyLoRaNode.PrjPcb]
2022-03-14 Adding .STEP format to the GPS box
    [gps-node-box.stl, gps_node_box_v1 v3.step]
2022-03-14 Adding assembly guide in spanish. Will translate to english
2022-03-15 Adding gps node bill of materials
    [bill_of_materials.xlsx]
2022-03-15 Adding data buoy node bill of materials
    [bill_of_materials.xlsx]
2022-03-15 Adding assembly guide
2022-03-15 Adding missing component to buoy bom
    [bill_of_materials.xlsx]
2022-03-15 Adding gerber files
    [cam.drl, rfm95w.gbl, rfm95w.gbs, rfm95w.gtl, rfm95w.gts]
2022-03-16 Adding i2c switching code
    [bill_of_materials.xlsx]
2022-03-16 Added i2c switching section
    Started the simple guide for switching the sensors to I2C mode from UART mode. Must still add the connection tables and maybe an image and a table with the i2c addresses.
2022-03-18 Finishing Switching to I2C mode section
2022-03-18 Commenting the switching to i2c code
2022-03-24 Adding Bill of Materials for Colombia.
    [BuoyLoRaNode.PrjPcb, bill_of_materials.xlsx, bill_of_materials_colombia.xlsx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]
2022-04-05 Adding data files
    [bill_of_materials_colombia.xlsx, coverage_map.xlsx, internaltemperature_data.xls, waterquality_data.csv]
2022-04-05 Adding data buoy 3d model
    [DataBuoy.step]
2022-05-06 Adding power consumption data and profile image
    [power_consumption_data.xlsx]
2022-05-06 Adding power consumption profile to readme
2022-05-09 Moving power consumption data file to data folder
    [power_consumption_data.xlsx]
2022-05-09 Reorganizing power data file location
    [power_consumption_data.xlsx]
2022-05-11 Updating flowchart and view images
