open-pisciculture/open-source-fish-farming-prototypes/(notices)

Notices in the files:
gps-node/software/prototype-gps-node/Core/Inc/main.h:
© Copyright (c) 2021 STMicroelectronics.
All rights reserved.
This software component is licensed by ST under BSD 3-Clause license,
the "License"; You may not use this file except in compliance with the
License. You may obtain a copy of the License at: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
(C) COPYRIGHT STMicroelectronics *****END OF FILE
data-buoy-node/software/switch-atlas-i2c/Core/Src/main.c:
© Copyright (c) 2022 STMicroelectronics.
rfm95w-breakout/altium/3DModels/SMA-J-P-H-ST-EM1.stp:
FILE_NAME( 'p:/temp/worker_146/temp/exporttempdir_5076_25_dyV5P/format_0/SMA-J-P-H-ST-EM1.stp', '2021-02-15T20:14:26', ( 'License CC BY-ND 4.0' ), ( 'CADENAS' ), ' ', 'PARTsolutions', ' ' );
